Xing-Zao/Shenfenpai-Guangyingtanceyi/README.md

# 灵笼身份牌和光影探测仪软硬件开源资料




[灵笼身份牌](https://www.bilibili.com/video/BV1do4y1f7v5) 和 灵笼光[影探测仪](https://www.bilibili.com/video/BV1FK411F7UJ)的配套软硬件资料。

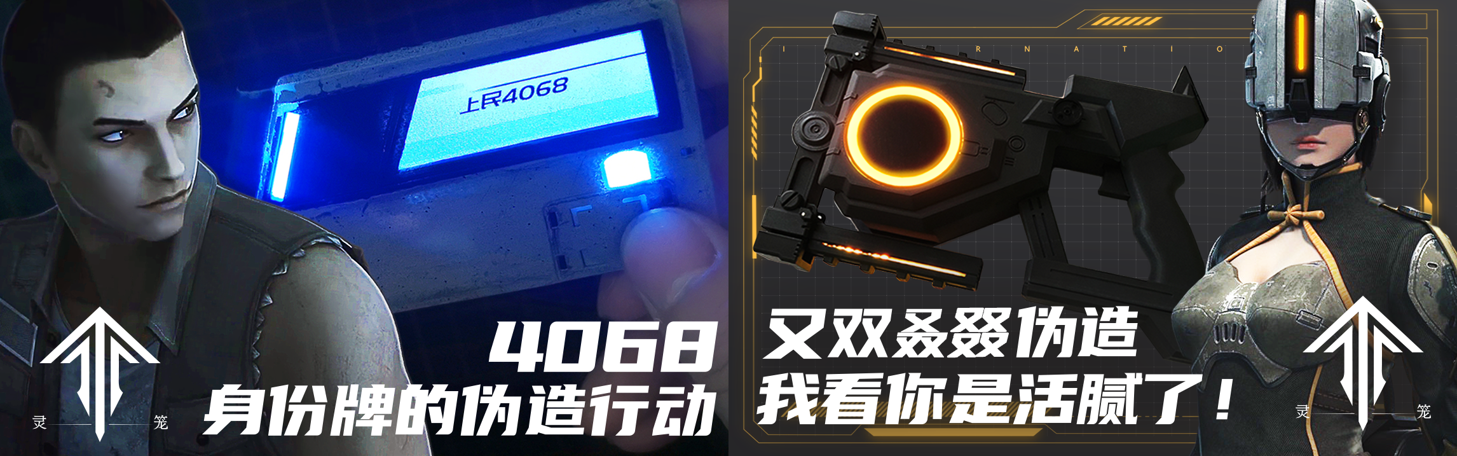
[picture p1: images/Posts/README/视频封面.png]
图 1
  

## 如何找到文件
- Light_detector 光影探测仪全部资料
- Badge 身份牌全部资料

每个文件夹下面都包含以下文件：
### 00_Priority README
该目录下存放了该控制板项目的全部**技术文档**，对该项目的程序源码、PCB设计都有详细说明，请首先阅读。
>文档目前尚未编写完成
>
### 01_Firmware
该目录下存放了 **软件/程序** 相关的全部源文件

### 02_Electronics
该目录下存放了 **电路/PCB** 相关的全部源文件

### 04_others
即不属于 软件/程序 也不属于 电路/PCB，但和本项目相关的其它文件

###  README.txt
每个文件夹下都有该文档，请**首先阅读**。这包含有其所处文件夹的阅读索引及一些重要说明。

## 支持

资料还在修改中，为了获得最佳的配置和故障排除帮助，请使用以下资源：
- 哔哩哔哩：[猩造](https://space.bilibili.com/16614468/)  
- 微信加群：
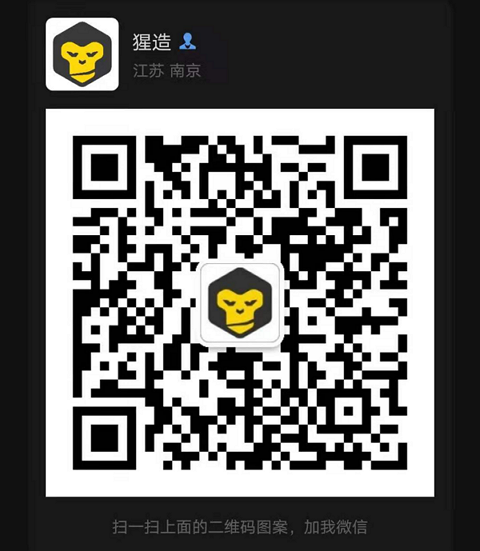
[picture p2: images/Posts/README/微信加群.png]
图 2
  

## 许可协议

FeixueMask 是遵循 [GPL license](/LICENSE) 协议发行的，因为我们相信开放式开发。 GPL附带了权利和义务。 无论您使用 FeixueMask 固件作为开源产品还是封闭源产品的驱动程序，都必须保持 FeixueMask 开放，并且必须根据要求向最终用户提供兼容的 FeixueMask 源代码。 遵守 FeixueMask 许可证的最直接方法是在 Github 上制作 FeixueMask 的分支，执行您的修改，并将用户引导到您修改后的分支。

虽然我们不能禁止在具有封闭源代码或有专利保护的产品中使用此代码，但我们还是希望您选择其他固件，或者最好自己制作。
