Xing-Zao/Shenfenpai-Guangyingtanceyi/Badge/Badge-A/02_Electronics/01_source/01_new_source/README.txt

A1.0  2020-08-18
  原理图错误：
    1. Q1 引脚1、2颠倒（main、LED）
    2. RX接MCU引脚错误，应接PA10（main）
    3. 电容C2~5 值错误，应为 0.1uF（main）

V1.0  2020-08-21
   版本更新：
     1. 修复上一版设计错误（main、LED）
     2. LED灯板重新设计，三色灯改为单色灯（LED）
  版本错误：
