Xing-Zao/Shenfenpai-Guangyingtanceyi/Badge/Badge-A/00_Priority README/技术文档源件.pdf

# 技术⽂档源件

# LonlyPan

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
灵笼-⾝份牌硬件开发技术⽂档

简介

功能

关键技术

难点

ToDo

约定

常⽤缩写及含义

+、-号

1、Alpha版

### 1.1 硬件设计

⽅案选择

充电

LCD显⽰屏

主控

flash

电路设计

### 1.2 软件设计

外设资源

初始化配置

主要流程

⽂件结构说明

API及函数说明

show_name()

change_to_up()

change_to_down()

remote_change_pic(u8 key)

LCD_Flash_Pic(u16 x,u16 y,u16 length,u16 width,const char* path)

Remote_Scan(void)

参考资料

# 灵笼-⾝份牌硬件开发技术⽂档

姓名 | LonlyPan
职位 | 嵌⼊式⼯程师
项⽬时间 | 2021/01/01 - 2021/05/10
2021/05/10 第⼀版
2020/xx/xx 第⼆版

灵笼-⾝份牌硬件开发技术⽂档

1/9

简介

该套设备是配套灵笼⾝份牌使⽤，模仿动漫中的功能，实现屏幕显⽰，红外接收信息。 相关视频：【灵笼】鸽了4个⽉，就做了这么个简单的胸牌？ (https://www.bilibili.com/video/BV1do4y1f7v5)
功能

通过屏幕显⽰两种⾝份状态，RGB灯跟随屏幕主⾊变化显⽰。 采⽤锂电池供电、可充电。
红外接收遥控信号，更改⾝份状态显⽰及其它⾃定义功能。 外置Flash存储，存放字库和显⽰图⽚，⽤于屏幕显⽰。
可通过usb_device 功能通过usb连接电脑⾃定义修改flash中的⽂本⽂件内容，通过红外遥控在屏幕中显 ⽰该⽂本内容。

## 关键技术

LCD 8位并口驱动显⽰
红外接收
RGB灯驱动
锂电池充放电
flash外置存储及模拟u盘
难点

TFT屏幕驱动
红外解码
Fatfs⽂件系统（访问Flash中⽂件）
USB_Device：连接PC修改Flash中⽂本⽂件内容 中⽂显⽰（含字库制作）
图⽚显⽰（从falsh读取显⽰）

## ToDo

NFC
续航增加
屏幕驱动修改为SPI，节省外设资源和布线

简介

2/9

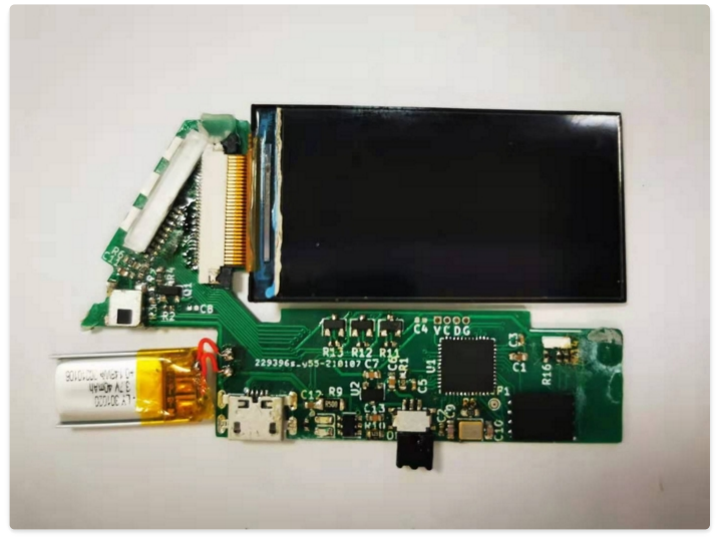
[picture p21: figure]

实物图

简介

3/9

约定

## 常⽤缩写及含义

+、-号

变量和函数前的

“+”号表⽰公有成员
“-”号表⽰私有成员

例如：
+boolenqueue(&item)：表⽰⽅法 enqueue(&item)为公有成员，对外公开 -enabled_globally：表⽰变量 enabled_globally为私有成员，只可在所在⽂件内访问
@file | ⽂件名
@author | 作者
@brief | 简要说明
@details | 实现细节
@param | ⽤于函数说明中，后⾯接参数名字，然后再接关于该参数的说明
@return | 返回值综述
@retval | 返回值列举并说明
@note | 注解信息
@attention | 注意信息
@warning | 警告信息
@see | 表⽰交叉参考
@ToDo | 计划实现的Marlin程序讲解1/34

约定

4/9

# 1、Alpha版

技术选型和验证阶段，⽅案未确⽴阶段

## 1.1 硬件设计

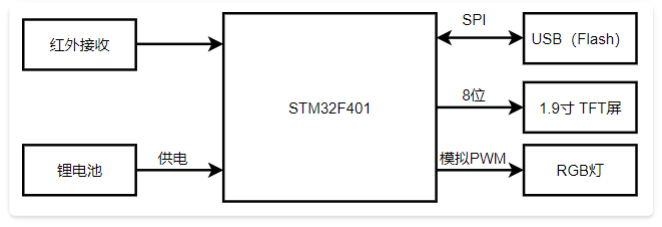
[picture p22: figure]

详细请阅读PCB设计⽂件。
BOM表中也列出了各元件的购买渠道。

## ⽅案选择

受限于外壳尺⼨，和内部电路板空间限制，屏幕、电池、USB接口、红外接收、RGB灯、flash的封装、外形均为限定， 故选择。

充电

充电芯⽚选择现有规格，另⼀⽅⾯也考虑了尺⼨因素。相同封装尺⼨下，也可选择其它充电芯⽚。⽆其它特殊技术 要求。

## LCD显⽰屏

LCD采⽤8位接口，考虑到显⽰速度因素。后期发现普通IO下⽆法使⽤DMA驱动，故速度⼀般。 下⼀版设计考虑 SPI+DMA 设计⽅案。

主控

采⽤常⽤、已有芯⽚。⽆其它特殊技术要求。

## flash

实际使⽤128M容量的，但64M即满⾜使⽤，两者仅驱动程序上需改。

系统框架

5/9

## 电路设计

电路设计部分均参考元件资料中的参考设计。

## 1.2 软件设计

## 外设资源

GPIO：屏幕8位并口驱动
TIM2：红外输⼊捕获
TIM10：RGB灯软件PWM驱动
SPI1：flash驱动
USB_FS、FATFS、USB_DEVICE：⽂件系统，USB通信

## 初始化配置

请参考程序源码。

## 主要流程

开机会显⽰4068上⺠（蓝⾊）图⽚、RGB灯光也显⽰为蓝⾊ 紧接会显⽰⾃定义内容（显⽰⾃定义内容（替换4068字符）或者显⽰⾃定义图⽚） 之后会移植扫描红外接收，科技通过遥控切换不同显⽰界⾯，或者显⽰4068上⺠和尘⺠切换动画。

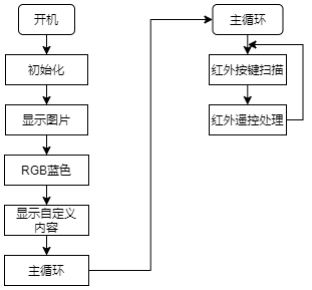
[picture p23: figure]

## ⽂件结构说明

Badge.c/h 主程序
cc.h ⾃定义⼀些数据类型供其它库⽂件使⽤

外设资源屏幕

6/9 common.h 最基础的公共头⽂件包含，基本每个源⽂件都要包含该头⽂件 lcd_font.h 常⽤ ASCII 字符表，⽤于LCD显⽰
lcd.c/h lcd底层驱动（初始话、发送命令等）,lcd⼀些简单画图功能函数 led.c/h RGB灯驱动
macros.h 公共声明定义
remoter.c/h 红外接收驱动
text.c/h 汉字显⽰
timer.c/h 定时器外设驱动
w25qxx.c/h W25QXX驱动代码

## API及函数说明

## show_name()

@brief: 显⽰⽤⼾⾃定义名称或三连图⽚
@note: 名称或图⽚只能同时显⽰⼀个。⾃定义名称来⾃⽂件 name.txt，需要⽤⼾⾃⼰修改，为空则不显⽰

## change_to_up()

@brief: 转为上⺠
@note: 根据动漫内容，展⽰从尘⺠变为上⺠的胸牌显⽰变化

## change_to_down()

@brief: 转为尘⺠
@note: 根据动漫内容，展⽰从上⺠变为尘⺠的胸牌显⽰变化

## remote_change_pic(u8 key)

@brief: 红外遥控处理
@note: 可使⽤遥控更改胸牌界⾯显⽰内容，不同遥控对应的键值可能会不同，需⾃⾏适配 @param {u8} key 红外遥控键值

## LCD_Flash_Pic(u16 x,u16 y,u16 length,u16 width,const char* path)

@brief 显⽰flash中的图⽚
@param: x,y起点坐标
@param: length 图⽚⻓度
@param: width 图⽚宽度
@param: *path 图⽚地址

## Remote_Scan(void)

7/9

@brief 处理红外键盘
@retval: 0,没有任何按键按下 其他,按下的按键键值.

## 参考资料

TFT屏幕驱动

STM32萌新学习笔记-LCD实验 (https://www.bilibili.com/read/cv6991648/)
⼀个简单的stm32vet6驱动2.4⼨240X320的8位并口tft屏DEMO (https://www.cnblogs.com/zjutlitao/p/4999363.html) 关于8位并口lcd写数据 (https://bbs.csdn.net/topics/390306089)
STM32 16位IO口操作的⼀些教训 (http://news.eeworld.com.cn/mcu/article_2017092634758.html)
请问STM32怎么才能并⾏操作低⼋位的IO口或⾼⼋位的IO口？ (https://zhidao.baidu.com/question/524842165.html) 基于 HAL 库⽣成的代码添加 GPIO 字节（组）操作功能 驱动1602 (https://www.jianshu.com/p/f579830bd6d0) ILI9341驱动的LCD屏刷屏很慢要什么解决？ (https://bbs.elecfans.com/jishu_1521747_1_1.html)
OLED显⽰屏驱动：8080并口，IIC，SPI三种驱动⽅式 (https://www.geek-share.com/detail/2791508605.html)
ili9341 8bit模式驱动说明 (https://www.pianshen.com/article/96241503123/)
ILI9341液晶显⽰ (https://www.shuzhiduo.com/A/A2dm6jn4ze/)
分享我的STM32刷图测试代码：STM32F103+SDIO+ILI9325 播放60fps视频 (https://www.amobbs.com/forum.php?mod=viewthread&tid=5597206&highlight=%25E8%25A7%2586%25E9%25A2%2591%252Bsdio) 怎么对⾼⼋位或低⼋位写值而不影响其它位，还有怎样单独读取⾼⼋位或低⼋位的值 (https://blog.csdn.net/TXF1984/article/details/46563521)

红外解码

主要参考正点原⼦红外解码例程。

红外遥控器-VS1838B/HS0038红外接收⽅案（包含原理图+PCB+BOM表+程序） (https://www.cnblogs.com/chengo/p/12759808.html) [每⽇电路图] 2、红外遥控电路原理设计与解析【转+解读】 (https://www.cnblogs.com/zjutlitao/p/5122983.html)

Fatfs⽂件系统、字库

STM32CubeMX系列教程18:⽂件系统FATFS (https://wiki.diustou.com/STM32CubeMX%25E7%25B3%25BB%25E5%2588%2597%25E6%2595%2599%25E7%25A8%258B18:%25E6%2596%2587%25E4%25BB%25B6%25E7%25B3%25BB%25E7%25BB%259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)
FSMC-TFT LCD调试记录 (https://stm32f407-tech-doc.readthedocs.io/en/latest/base/13FSMC/FSMC-TFT%20LCD%25E8%25B0%2583%25E8%25AF%2595%25E8%25AE%25B0%25E5%25BD%2595.html)
HAL库教程【HAL库每天⼀例】第054例：LCD-显⽰图⽚(图⽚在SD卡) (http://www.ing10bbs.com/forum.php?mod=viewthread&tid=312) 基于stm32f103zet6的FAT16⽂件系统学习4（管理SD卡，读取图⽚，字库） (http://www.javamy.com/it/x1843717577511633000/stm32) Tutorial: An SD card over SPI using STM32CubeIDE and FatFS (https://01001000.xyz/2020-08-09-Tutorial-STM32CubeIDE-SD-card/) stm32--FatFs调试过程（SPIFlash） (http://itren.xiaolee.net/p/2148706.html)
stm32--FatFs移植（SPIFlash） (https://www.cnblogs.com/cage666/p/9178326.html)
STM32Cube-20（补充）| 在SD卡上移植FATFS⽂件系统 (https://cloud.tencent.com/developer/article/1662818)

字体显⽰

【教程】中英⽂显⽰取模设置 (http://www.lcdwiki.com/zh/%25E3%2580%2590%25E6%2595%2599%25E7%25A8%258B%25E3%2580%2591%25E4%25B8%25AD%25E8%258B%25B1%25E6%2596%2587%25E6%2598%25BE%25E7%25A4%2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)

开发板通⽤（\ 128*128\）⼤字体常⽤ASCII显⽰ (http://www.openedv.com/forum.php?mod=viewthread&tid=289623) 8/9 miniF103 MINIV3 32号字体显⽰测试程序（从SPI FLASH读取汉字字库） (http://www.openedv.com/forum.php?mod=viewthread&tid=279050&highlight=32%25BA%25C5%25D7%25D6%25CC%25E5)

显⽰24*24字体 (http://www.openedv.com/thread-4920-1-1.html)

STM32汉字字库显⽰（从SD卡读取数据） (http://bbs.eeworld.com.cn/thread-493755-1-1.html)

基于STM32的简单电⼦书的实现 (https://zhuanlan.zhihu.com/p/79174160)

原创 littlevgl(LVGL v7.0) 外部SD卡存放中⽂字库并显⽰ (https://www.stmcu.org.cn/module/forum/thread-625813-1-1.html)

汉字点阵字库模块 (https://stm32f407-tech-doc.readthedocs.io/en/latest/base/26%25E6%25B1%2589%25E5%25AD%2597%25E5%25AD%2597%25E5%25BA%2593/%25E6%25B1%2589%25E5%25AD%2597%25E7%25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)

USB_Device

STM32HAL----USB串⾏FLASH模拟U盘 (https://blog.csdn.net/a3748622/article/details/80347730) 基于STM32F103C8的 USB 外部flash虚拟U盘 (https://blog.csdn.net/qq997758497/article/details/102763470) STM32f103+W25Q64实现虚拟U盘和FATFS⽂件系统 (https://blog.csdn.net/Jun626/article/details/80426643) STM32的USB-Device不能识别问题的解决 (https://blog.csdn.net/qq_16597387/article/details/93094052)
How to use Flash Drive with STM32 || USB HOST MSC || CubeIDE (https://www.youtube.com/watch?v=_bfROydrssA) STM32 USB Mass Storage 例程调试笔记【转载】 (http://blog.sina.com.cn/s/blog_7880d3350101n2ja.html) STM32+FLASH实现u盘(2) (http://www.ec66.com/article/list.asp?indexid=4656)
⽤STM32CubeMX快速⽣成⼀个U盘模拟程序 (https://wenku.baidu.com/view/6883eccf9fc3d5bbfd0a79563c1ec5da50e2d6c1.html?re=view)
stm32模拟U盘，cubemx⽣成的代码，可以看到盘⽆法格式化 (http://47.111.11.73/thread-304933-1-1.html) 已解决 STM32F103VE SPI1驱动SD卡模拟U盘，⽆法格式化 (https://www.stmcu.org.cn/module/forum/thread-597120-1-1.html) STM32F446移植USB驱动，实现外部FLASH模拟U盘 (https://blog.csdn.net/asher__zhou/article/details/105916971) 使⽤STM32CUBEMX 新HAL库TF卡模拟U盘不能格式化问题 (https://blog.csdn.net/ffmydream/article/details/89926213) STM32 USB-Host-Device_Lib_V2.1.0 SPIflash ⽆法格式化问题 (https://www.cnblogs.com/alinweb/p/3520660.html) stm32USB之模拟U盘 (https://blog.csdn.net/qq_38420206/article/details/110572003)
STM32CbueMX之USB挂载内存虚拟U盘 (https://blog.csdn.net/sudaroot/article/details/94602949)

9/9
