Xing-Zao/Shenfenpai-Guangyingtanceyi/Badge/Badge-A/README.txt

00_Priority README ------------- 技术文档，首先阅读
01_Firmware --------------------- 软件相关文件夹
02_Electronics -------------------- 电路相关文件夹
03_Machines --------------------- 机械相关文件夹
04_others ------------------------ 其他文件

README,txt --------------------- 每个分类文件夹都有，含有所处文件夹的阅读索引及必要说明，请最先阅读
