Xing-Zao/Shenfenpai-Guangyingtanceyi/Badge/Badge-A/00_Priority README/README.txt

01-source ---- 存放技术文档源文档

xxx.pdf为技术文档(上述源文档的导出版)
