Xing-Zao/Shenfenpai-Guangyingtanceyi/Badge/Badge-A/02_Electronics/01_source/README.txt

01_new_source -------------------------------- 存放最新源码（该目录仅存放一个最新版本）
    |________ Vx.x.x  --------------------  最新版本号
	     |________ 源码名1
	     |________ 源码名2  --------------------  有的工程可能会有同时多个源码

02_old_source --------------------------------- 存放已迭代源码
    |________ Vx.x.x  --------------------  旧版本号
	     |________ 源码名1
	     |________ 源码名2
    |________ Vx.x.x  --------------------  旧版本号
	 ......

有的编程软件可能不支持中文路径，需单独保存到全英文路径在运行
