Xing-Zao/Shenfenpai-Guangyingtanceyi/Badge/Badge-A/00_Priority README/01_source/README.txt

该文件夹下存放技术文档的源文档

如果想要阅读该目录下的文件，请转至该文件夹的上级文件夹，阅读其内与该文件夹同名的 .pdf 文件（.pdf为该目录下 .md文档 的导出文件）。

请使用 Visual Studio Code 打开该文件的所属文件夹（01_source），打开.md文档编辑修改。
vs code插件推荐：
    Markdown Image
    Markdown Preview Enhanced
