Xing-Zao/Shenfenpai-Guangyingtanceyi/Light_detector/04_others/红外解码模块+编码模块+红外无线通信+接收发射串口通信模块/YS-NEC编解码模块 原理图.pdf

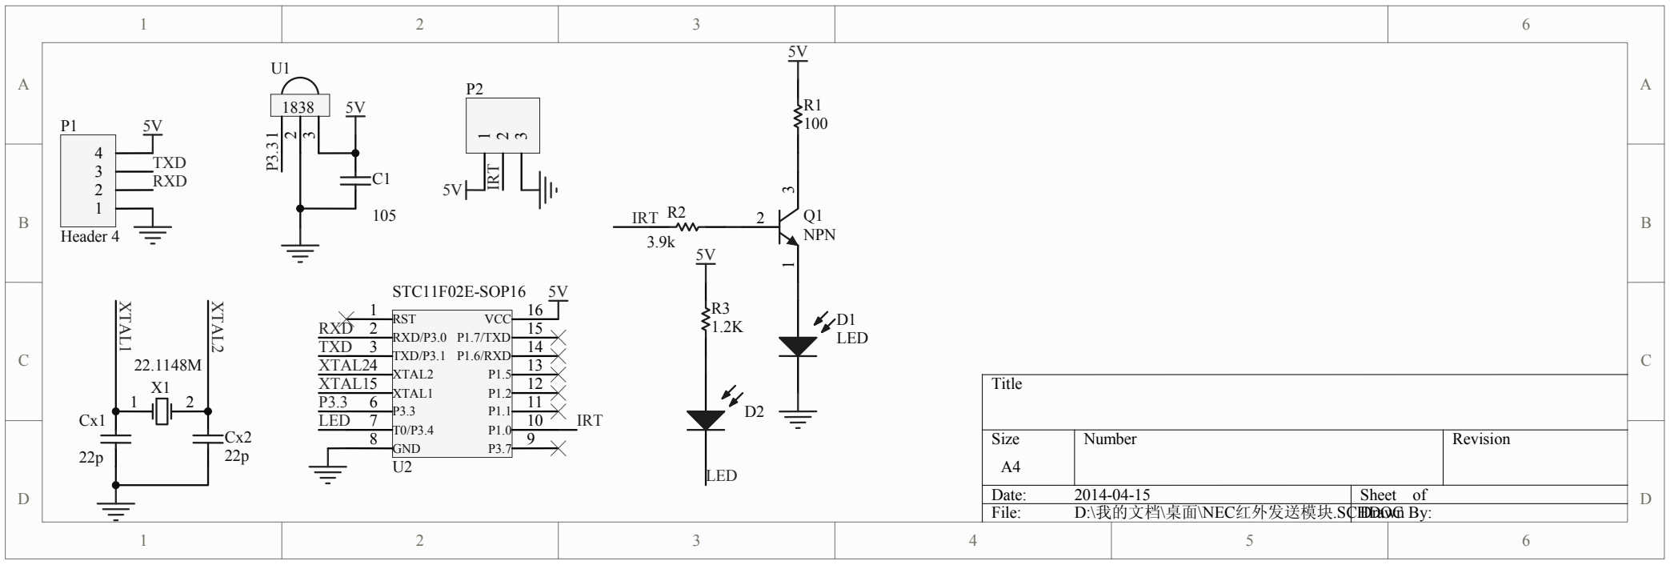
[picture p27: figure]
umb; HDDraOwCn; XTAL2; XTAL1; IRT
