Xing-Zao/Shenfenpai-Guangyingtanceyi/images/Posts/README/个人二维码.jpg

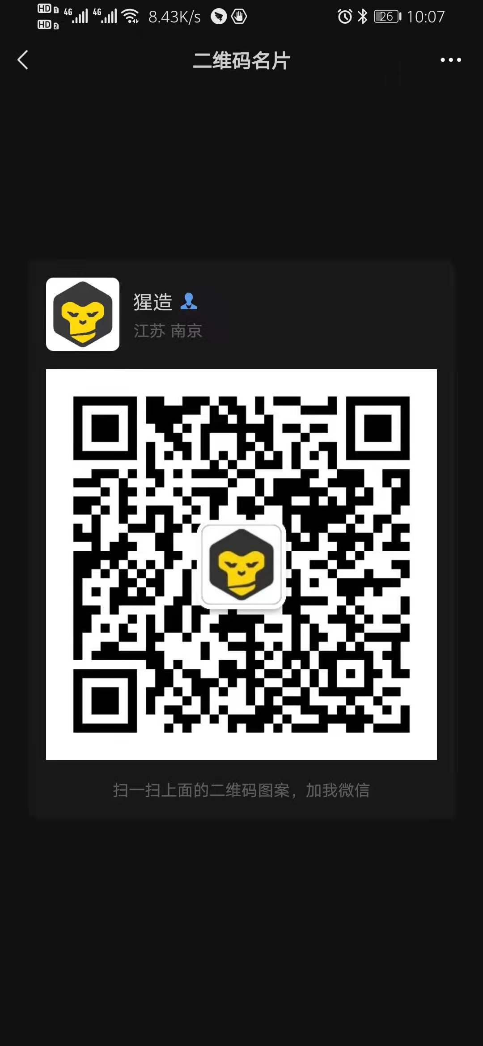
images/Posts/README/个人二维码.jpg
