Xing-Zao/Shenfenpai-Guangyingtanceyi/Light_detector/04_others/04-LCD取模教程/page1.jpg

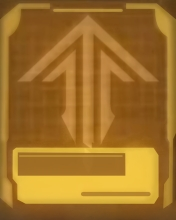
Light_detector/04_others/04-LCD取模教程/page1.jpg
