Xing-Zao/Shenfenpai-Guangyingtanceyi/Light_detector/04_others/04-LCD取模教程/已完成.jpg

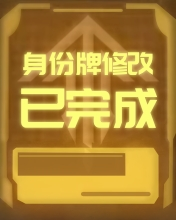
Light_detector/04_others/04-LCD取模教程/已完成.jpg
