Xing-Zao/Shenfenpai-Guangyingtanceyi/Light_detector/04_others/04-LCD取模教程/读取中.jpg

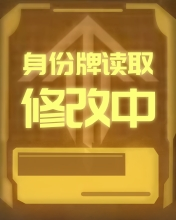
Light_detector/04_others/04-LCD取模教程/读取中.jpg
