Xing-Zao/Shenfenpai-Guangyingtanceyi/Light_detector/02_Electronics/01_source/01_new_source/main_V1.1/BOM/BOM.xlsx

Reference | Quantity | Value | Footprint | Datasheet | Description | 采购建议
BT1 | 1 | Battery | JWT_A3963_1x02_P3.96mm_Vertical |  | 电源接头，人工焊接 | 无需购买
C1 C7 C11 C10 C13 | 5 | 22uF | C_1206_3216Metric | ~ |  | 非指定厂家，符合：Value、Footprint 即可
C12 | 1 | 330nF | C_0402_1005Metric | ~ |  | 非指定厂家，符合：Value、Footprint 即可
C14 C23 | 2 | 2.2uF | C_0603_1608Metric | ~ |  | 非指定厂家，符合：Value、Footprint 即可
C15 C18 | 2 | 1uF | C_0603_1608Metric | ~ |  | 非指定厂家，符合：Value、Footprint 即可
C17 C16 | 2 | 22pF | C_0402_1005Metric | ~ |  | 非指定厂家，符合：Value、Footprint 即可
C19 C20 C21 C22 | 4 | 0.1uF | C_0402_1005Metric | ~ |  | 非指定厂家，符合：Value、Footprint 即可
C2 | 1 | 10nF | C_0402_1005Metric | ~ |  | 非指定厂家，符合：Value、Footprint 即可
C6 C5 C3 C4 | 4 | 100nF | C_0402_1005Metric | ~ |  | 非指定厂家，符合：Value、Footprint 即可
C8 | 1 | 82pF | C_0402_1005Metric | ~ |  | 非指定厂家，符合：Value、Footprint 即可
C9 C24 | 2 | 4.7uF | C_1206_3216Metric | ~ |  | 非指定厂家，符合：Value、Footprint 即可
D1 | 1 | SS34 | D_SMA | 见数据表：01-SS34_2019-07-29.PDF |  | 指定厂家
D2 | 1 | G | LED_0603_1608Metric | ~ | 绿色 | 非指定厂家，符合：Value、Footprint 即可
D3 | 1 | R | LED_0603_1608Metric | ~ | 红色 | 非指定厂家，符合：Value、Footprint 即可
D4 | 1 | remote | Con-2.5mm_0.9x1.7 | ~ | 红外发射LED接口，人工焊接 | 无需购买
D5 | 1 | B550C | D_SMC | ~ | 肖特基二极管 | 非指定厂家，符合：Value、Footprint 即可
IC1 IC2 | 2 | HY2213-BB3A | SOT95P280X140-6N | 见数据表：02-DS-HY2213_单节电池_充电平衡.pdf |  | 指定厂家
IC3 | 1 | RT8279GSP | Diodes_SO-8EP | 见数据表：03-RT8279GSP-5V_DC-DC_5A-降压_2017-07-12.PDF |  | 指定厂家
J1 | 1 | USB_B_Micro | USB_Micro-B_Molex-105017-0001 | 见数据表：04-MICROUSB母座小牛角有柱卷边编带_2019-07-22.PDF |  | 指定厂家
J6 | 1 | SERVOA | Connector_PinHeader_2.54mm:PinHeader_1x03_P2.54mm_Horizontal | ~ | 舵机接口，2.54弯排针 | 非指定厂家，符合：Value、Footprint 即可
J10 | 1 | SERVOB | PinHeader_1x03_P2.54mm_Horizontal | ~
J2 | 1 | BAT | JST_XH_S3B-XH-A-1_1x03_P2.50mm_Horizontal | ~ | 电池充电接口，，XH 3A 母座 | 非指定厂家，符合：Value、Footprint 即可
J4 | 1 | SWD | Connector_PinHeader_1.27mm:PinHeader_1x04_P1.27mm_Vertical | ~ | 下载调试接口，不焊接 | 无需购买
J5 | 1 | Conn_01x16 | Connector_FFC-FPC:TE_1-1734839-6_1x16-1MP_P0.5mm_Horizontal | ~ | FPC连接器 0.5MM 翻盖下接 16P | 非指定厂家，符合：Value、Footprint 即可
J7 | 1 | LEDA | JST_XH_S3B-XH-A-1_1x03_P2.50mm_Horizontal | ~ | WS2812 灯带接口，XH 3A 母座 | 非指定厂家，符合：Value、Footprint 即可
J11 | 1 | LEDB | JST_XH_S3B-XH-A-1_1x03_P2.50mm_Horizontal | ~
J8 | 1 | LEDC | JST_XH_S3B-XH-A-1_1x03_P2.50mm_Horizontal | ~
J9 | 1 | LEDD | JST_XH_S3B-XH-A-1_1x03_P2.50mm_Horizontal | ~
L1 | 1 | 3.3uH | L_Sumida_CDMC6D28_7.25x6.5mm | 见数据表：05-3.3UH±20%6A_2019-05-30.PDF | MCS0630-3R3MN2 | 指定厂家，厂家编号：MCS0630-3R3MN2
L2 | 1 | 10uH | L_Neosid_SM-PIC1004H | 见数据表：06-10UH±20%6A_2020-07-20.PDF |  | 指定厂家，厂家编号：PSPMAA1040H-100M-ANP
Q1 Q2 | 2 | SI2300 | SOT-23 | 见数据表：07-SI2300-N_MOSFET_2020-04-16.PDF |  | 指定厂家
Q5 Q4 | 2 | SS8050 | SOT-23 | 见数据表：08-SS8050Y1200-350.PDF |  | 指定厂家
R11 | 1 | 31.6k | R_0402_1005Metric | ~ |  | 非指定厂家，符合：Value、Footprint 即可
R14 | 1 | 5.1K | R_0402_1005Metric | ~
R15 R4 R10 | 3 | 100K | R_0402_1005Metric | ~
R16 | 1 | 10M | R_0402_1005Metric | ~
R17 R21 | 2 | 100R | R_0603_1608Metric | ~
R18 R12 R13 R19 | 4 | 1K | R_0402_1005Metric | ~
R23 | 1 | 10R | R_0603_1608Metric | ~
R5 R20 R22 R3 R6 | 5 | 10K | R_0402_1005Metric | ~
R7 R1 R2 | 3 | 100R | R_0402_1005Metric | ~
R8 R9 | 2 | 20R | R_2512_6332Metric | ~
SW1 | 1 | Power_BT | JST_XH_S2B-XH-A-1_1x02_P2.50mm_Horizontal | ~ | 电源开关接口，XH2A，实际短接 | 无需购买
U1 | 1 | SLM4800 | QFN-16-1EP_4x4mm_P0.65mm_EP2.1x2.1mm_ThermalVias | 见数据表：09-SLM6800-两节锂电池升压充电IC_2019-04-19.PDF |  | 指定厂家
U2 | 1 | XC6206 | SOT-23 | 见数据表：10-XC6206P302MR.PDF |  | 指定厂家
U3 | 1 | STM32F401CCUx | QFN-48-1EP_7x7mm_P0.5mm_EP5.6x5.6mm | 见数据表：11-STM32F401CCU6_2016-08-16.PDF |  | 指定厂家
U4 | 1 | TSMP58138 | Vishay_MINICAST-3Pin |  | 红外接收芯片，实际未用到、保留设计 | 无需购买
U5 | 1 | W25Q128JVS | SON127P800X600X80-9N-D | 见数据表：12-W25Q64JVZEIQ_2020-06-23.PDF |  | 指定厂家
U8 U6 U7 | 3 | SN74LVC2T45DCUR | VSSOP-8_2.4x2.1mm_P0.5mm | 见数据表：13-SN74LVC2T45DCUR-电平转换_2014-07-11.PDF |  | 指定厂家
U9 | 1 | AO4459 | SOP-8_3.9x4.9mm_P1.27mm | 见数据表：14-AO4459-30V_6.5A-P_MOS-2015-06-01.PDF |  | 指定厂家
Y1 | 1 | 25MHz/20pF/10ppm | Crystal_SMD_2520-4Pin_2.5x2.0mm | 见数据表：15-25M20PPM20PF-30+85℃_2018-07-26.PDF |  | 指定厂家
其它原件
 | 1 | 锂电池 | 2S 5C 7.4V 圆柱锂电池 SM公头 |  |  | 推荐厂家：淘宝：汇成玩具电池 型号：7.4V 18650 圆柱锂电池
 | 1 | 2.2寸显示屏 | 2.2寸TFT液晶屏 插接式 MCU 8位 | 见数据表：16-CL22BK122-16A.pdf |  | 指定厂家，淘宝：永达创力 型号：2.2寸TFT液晶屏 显示屏 彩屏 插接式 插拔式屏 LCD液晶屏MCU 8位
 |  | FPC排线 | 16P 间距0.5mm 长度25cm 同向 | ~ | 屏幕接线延长线 | 非指定厂家，符合：Value、Footprint 即可
 |  | FPC延长板 | 0.5mm间距 16P FPC/FFC软排线扁平线延长板 |  | 延长转接板 | 非指定厂家，符合：Value、Footprint 即可
 |  | 红外发射头 | 3MM发射管 940nm红外发射管 |  | 插件 | 非指定厂家，符合：Value、Footprint 即可
