Xing-Zao/Shenfenpai-Guangyingtanceyi/Badge/Badge-A/02_Electronics/01_source/01_new_source/main_V1.0/BOM/BOM.xlsx

Reference | Quantity | Value | Footprint | Datasheet | Description | 采购建议
BT1 | 1 | Li-on | Pad-2.2mm_1.5x1.5 | ~ | 电池接口焊点，人工焊接 | 无需购买
C1 C11 | 2 | 2.2uF ±10% 6.3V/10V/16V | C_0603_1608Metric | ~ |  | 非指定厂家，符合：Value、Footprint 即可
C10 C9 | 2 | 22pF ±10% 6.3V/10V/16V | C_0603_1608Metric | ~ |  | 非指定厂家，符合：Value、Footprint 即可
C2 C3 C4 C5 C8 | 5 | 0.1uF ±10% 6.3V/10V/16V | C_0402_1005Metric | ~ |  | 非指定厂家，符合：Value、Footprint 即可
C6 C7 C12 C13 | 4 | 1uF ±10% 6.3V/10V/16V | C_0603_1608Metric | ~ |  | 非指定厂家，符合：Value、Footprint 即可
D2 | 1 | G_LED IF<25mA | LED_0603_1608Metric | ~ |  | 非指定厂家，符合：Value、Footprint 即可
D3 | 1 | R_LED IF<25mA | LED_0603_1608Metric | ~ |  | 非指定厂家，符合：Value、Footprint 即可
IC1 | 1 | TP4057 | SOT-23-6 | 见数据表：02-TP4057_2020-08-19.pdf | 锂电池充电芯片 | 指定厂家
J1 | 1 | Conn_01x30 | FFC-1x30-1MP_P0.5mm_Horizontal | 见数据表：03_FFCFPC连接器0.5MM间距30P卧贴抽拉式上接H1.2MM_2020-10-20.pdf | FFC 连接器 0.5mm间距 30P 卧贴抽拉式上接 H1.2mm | 指定厂家
J2 | 1 | USB_B_Micro | USB_Micro-B_Molex_Sink | 见数据表：04-MICRO_5SB型沉板式0.8四脚全插无导位有孔三边双卡端_2021-03-08.pdf | MICRO/5S B型沉板式0.8四脚全插无导位有孔三边双卡端 | 指定厂家
J3 | 1 | SWD | Con-1x4-P1.25mm | ~ | 下载调试接口，不焊接 | 无需购买
Q1 Q2 Q4 Q3 | 4 | SS8050 | SOT-23 | 见数据表：05-SS8050Y1200-350.pdf |  | 指定厂家
R1 | 1 | 100K ±5% 0.1W_1/16W | R_0603_1608Metric | ~ |  | 非指定厂家，符合：Value、Footprint 即可
R10 | 1 | 3K ±5% 0.1W_1/16W | R_0603_1608Metric | ~ |  | 非指定厂家，符合：Value、Footprint 即可
R14 R15 R16 R17 R18 R19 R20 R21 R22 R23 R24 R25 | 12 | 470R ±5% 0.1W_1/16W | R_0402_1005Metric | ~ |  | 非指定厂家，符合：Value、Footprint 即可
R2 R8 R11 R13 R12 | 5 | 1K ±5% 0.1W_1/16W | R_0402_1005Metric | ~ |  | 非指定厂家，符合：Value、Footprint 即可
R3 R7 | 2 | 10K ±5% 0.1W_1/16W | R_0603_1608Metric | ~ |  | 非指定厂家，符合：Value、Footprint 即可
R4 | 1 | 10R ±5% 0.1W_1/16W | R_0603_1608Metric | ~ |  | 非指定厂家，符合：Value、Footprint 即可
R5 | 1 | 10M ±5% 0.1W_1/16W | R_0603_1608Metric | ~ |  | 非指定厂家，符合：Value、Footprint 即可
R6 | 1 | 100R ±5% 0.1W_1/16W | R_0603_1608Metric | ~ |  | 非指定厂家，符合：Value、Footprint 即可
R9 | 1 | 0.5R ±5% 0.1W_1/16W | R_0805_2012Metric | ~ |  | 非指定厂家，符合：Value、Footprint 即可
SW1 | 1 | SW_SPDT | MSKT-12C00-switch-smd | 见数据表：10-开关规格.png | 侧贴拨动开关 | 指定厂家，淘宝：温州一键电子科技，型号MSKT-12C00 黑色
TP1 | 1 | NRST | TestPoint_Pad_D1.0mm | ~ | 测试焊点，不焊接 | 无需购买
U1 | 1 | STM32F401CCUx | QFN-48-1EP_7x7mm_P0.5mm_EP5.6x5.6mm | 见数据表：06-STM32F401CCU6_2016-08-16.pdf | 主控芯片，型号 STM32F401CCU6 | 指定厂家
U2 | 1 | XC6206 | SOT-23 | 见数据表：07-XC6206P302MR.pdf | 稳压降压芯片 | 指定厂家
U3 | 1 | IRM-H2XXT_TR2 | IRM-H2XXT_TR2 | 见数据表：08-红外线接收头38KHZ贴片_2017-09-18.PDF | 红外接收头 | 指定厂家
U4 | 1 | W25Q128JVS | SON127P800X600X80-9N-D | 见数据表：09-W25Q64JVZEIQ_2020-06-23.PDF | flash芯片，型号W25Q64JVIQ，封装WSON 8x6mm | 指定厂家
U5 U7 U8 U6 | 4 | LEB_BGAR | RGB-3510-Side-Common_anode | 见数据表：11-3510侧发RGB全彩_2020-09-04.PDF | 侧贴RGB全彩 | 指定厂家
Y1 | 1 | 25MHz/20pF/10ppm | Crystal_SMD_2520-4Pin_2.5x2.0mm | 见数据表：12-25M20PPM20PF-30+85℃_2018-07-26.PDF |  | 指定厂家
其它原件
 | 1 | 锂电池 | 尺寸：20x10x3mm 容量40mAh，带保护板 |  |  | 指定厂家，淘宝：裕辉达玩具数码电池户，型号301020 50mAh，带保护板
 | 1 | 1.9寸显示屏 | 1.9寸长条形IPS全视角170*320分辨率MCU接口 | 见数据表：13-TL019FQV01-B1263A_specification.pdf |  | 指定厂家，淘宝：深圳市显创液晶显示有限公司 型号：1.9寸长条形显示屏IPS全视角170*320分辨率
 | 1 | 背光板 | 18*8*1.3 |  | RGB侧面显示匀光板，需手工裁切 | 指定厂家，淘宝：深圳市宝晖光电 型号：18*8*1.3 白色背光板
