Xing-Zao/Shenfenpai-Guangyingtanceyi/Light_detector/04_others/2.2寸-176x220-9225G-8位-插接/CL22BK122-16A接线图.pdf

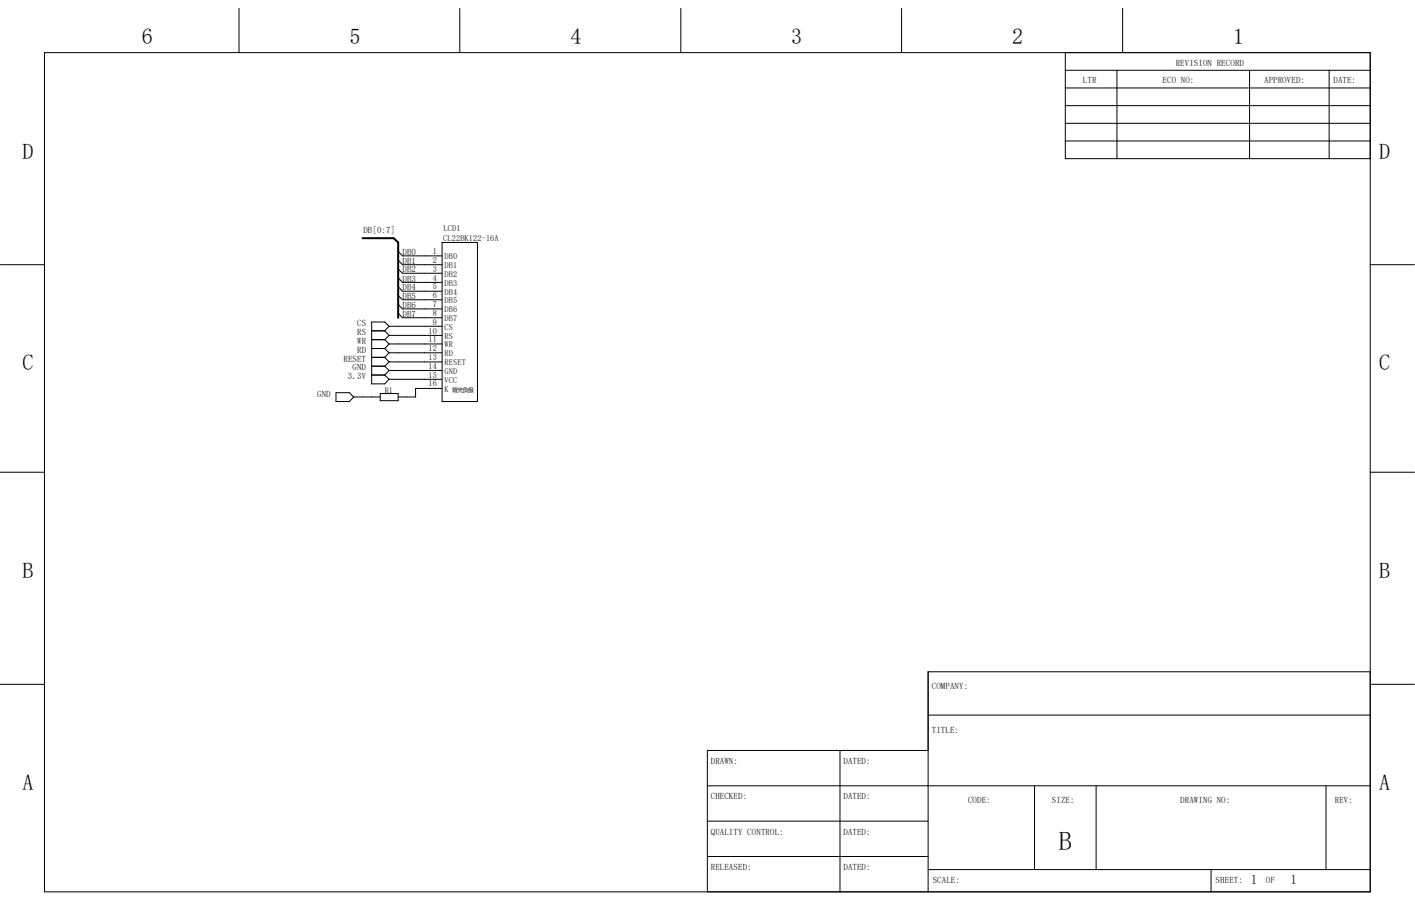
[picture p35: page 1]
COMPANY:; TITLE:; 背光负极; RESET 14; GND 15; VCC 16; CS RS WR RD RESET GND 3.3V; GND

LCD1 CL22BK122-16A | REVISION RECORD

LTR | ECO NO: | APPROVED: | DATE:

DRAWN: | DATED:
CHECKED: | DATED: | CODE: | SIZE: B | DRAWING NO: | REV:

QUALITY CONTROL: | DATED:

RELEASED: | DATED:

SCALE: | SHEET: 1 1 OF
