Xing-Zao/Shenfenpai-Guangyingtanceyi/Light_detector/02_Electronics/01_source/01_new_source/main_V1.1/Light_detector_V1.0.pdf

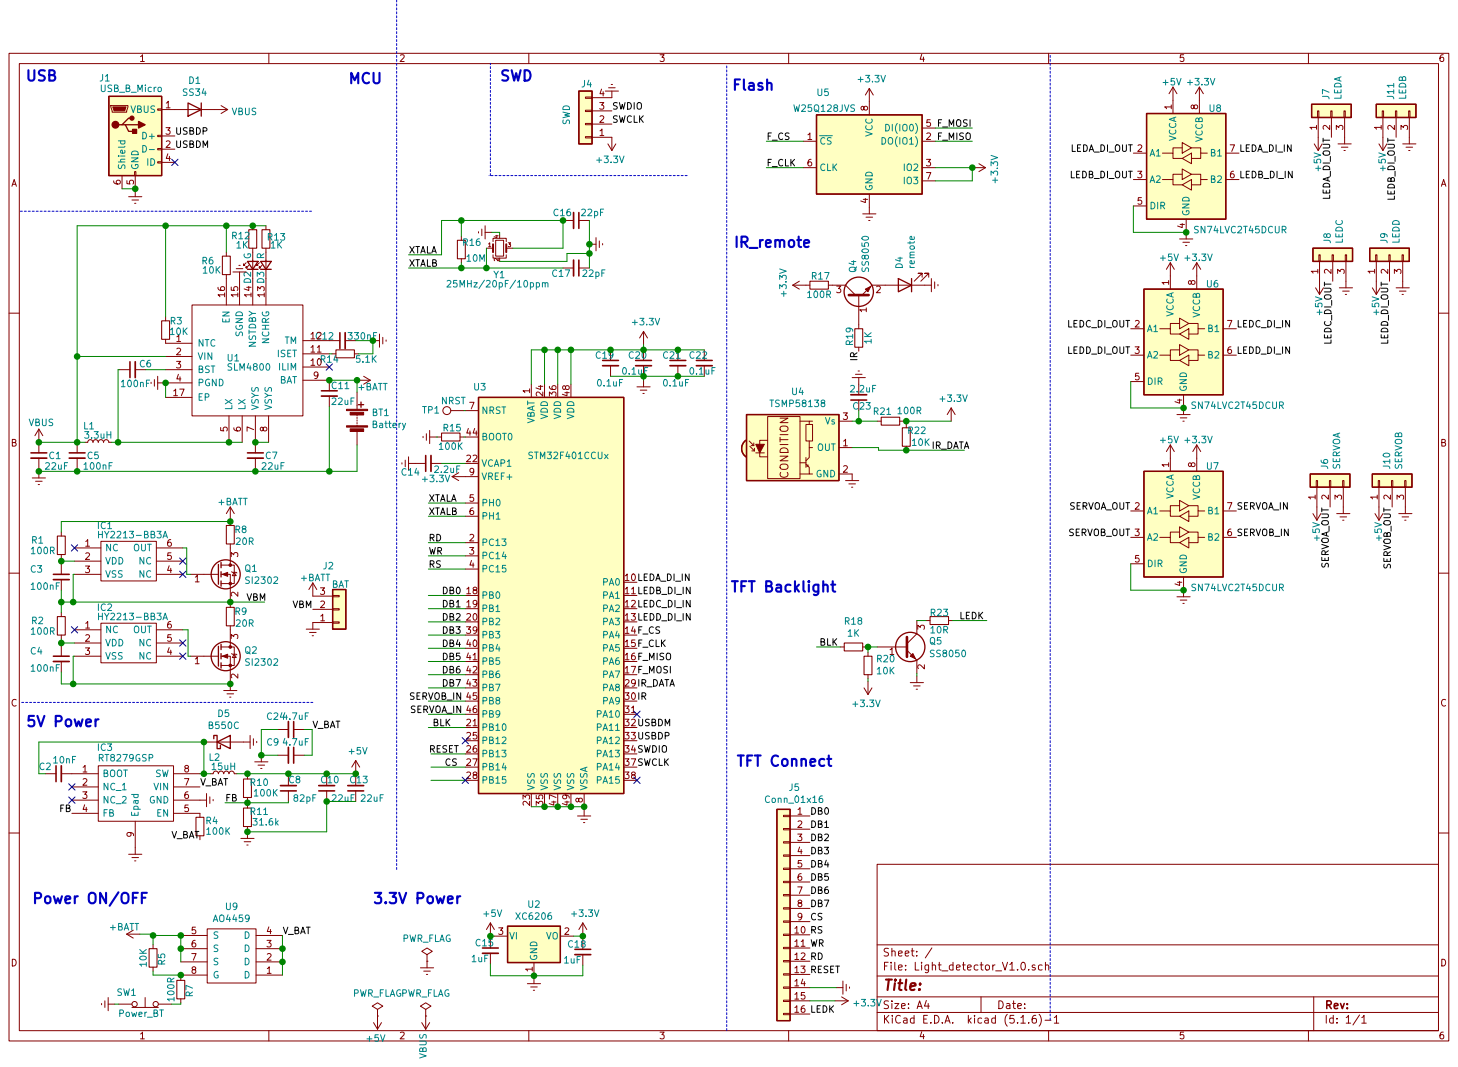
[picture p36: page 1]

1 VCAP1 22 VDD 24 VDD 36 VDD 48 VREF+ 9 VSS 23 VSS 35 VSS 47 VSS 49 VSSA
