Xing-Zao/Shenfenpai-Guangyingtanceyi/Badge/Badge-A/02_Electronics/01_source/01_new_source/main_V1.0/BOM/03_FFCFPC连接器0.5MM间距30P卧贴抽拉式上接H1.2MM_2020-10-20.PDF

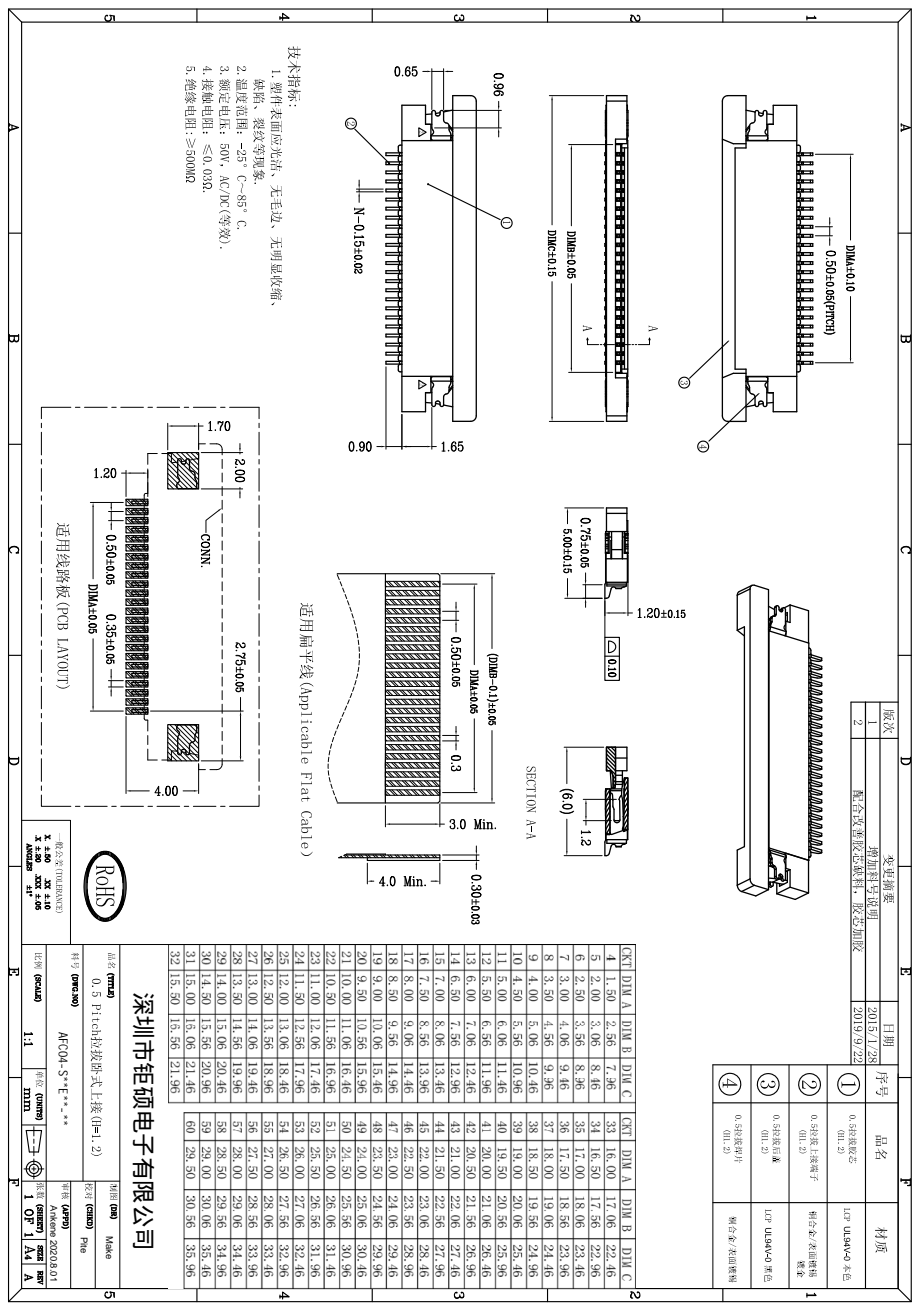
[picture p37: page 1]
深圳市钜硕电子有限公司; AFC04-S**E**-**; Ankene 2020.8.01; Pite; Make
