Xing-Zao/Shenfenpai-Guangyingtanceyi/Badge/Badge-A/02_Electronics/01_source/01_new_source/main_V1.0/BOM/04-MICRO_5SB型沉板式0.8四脚全插无导位有孔三边双卡端_2021-03-08.PDF

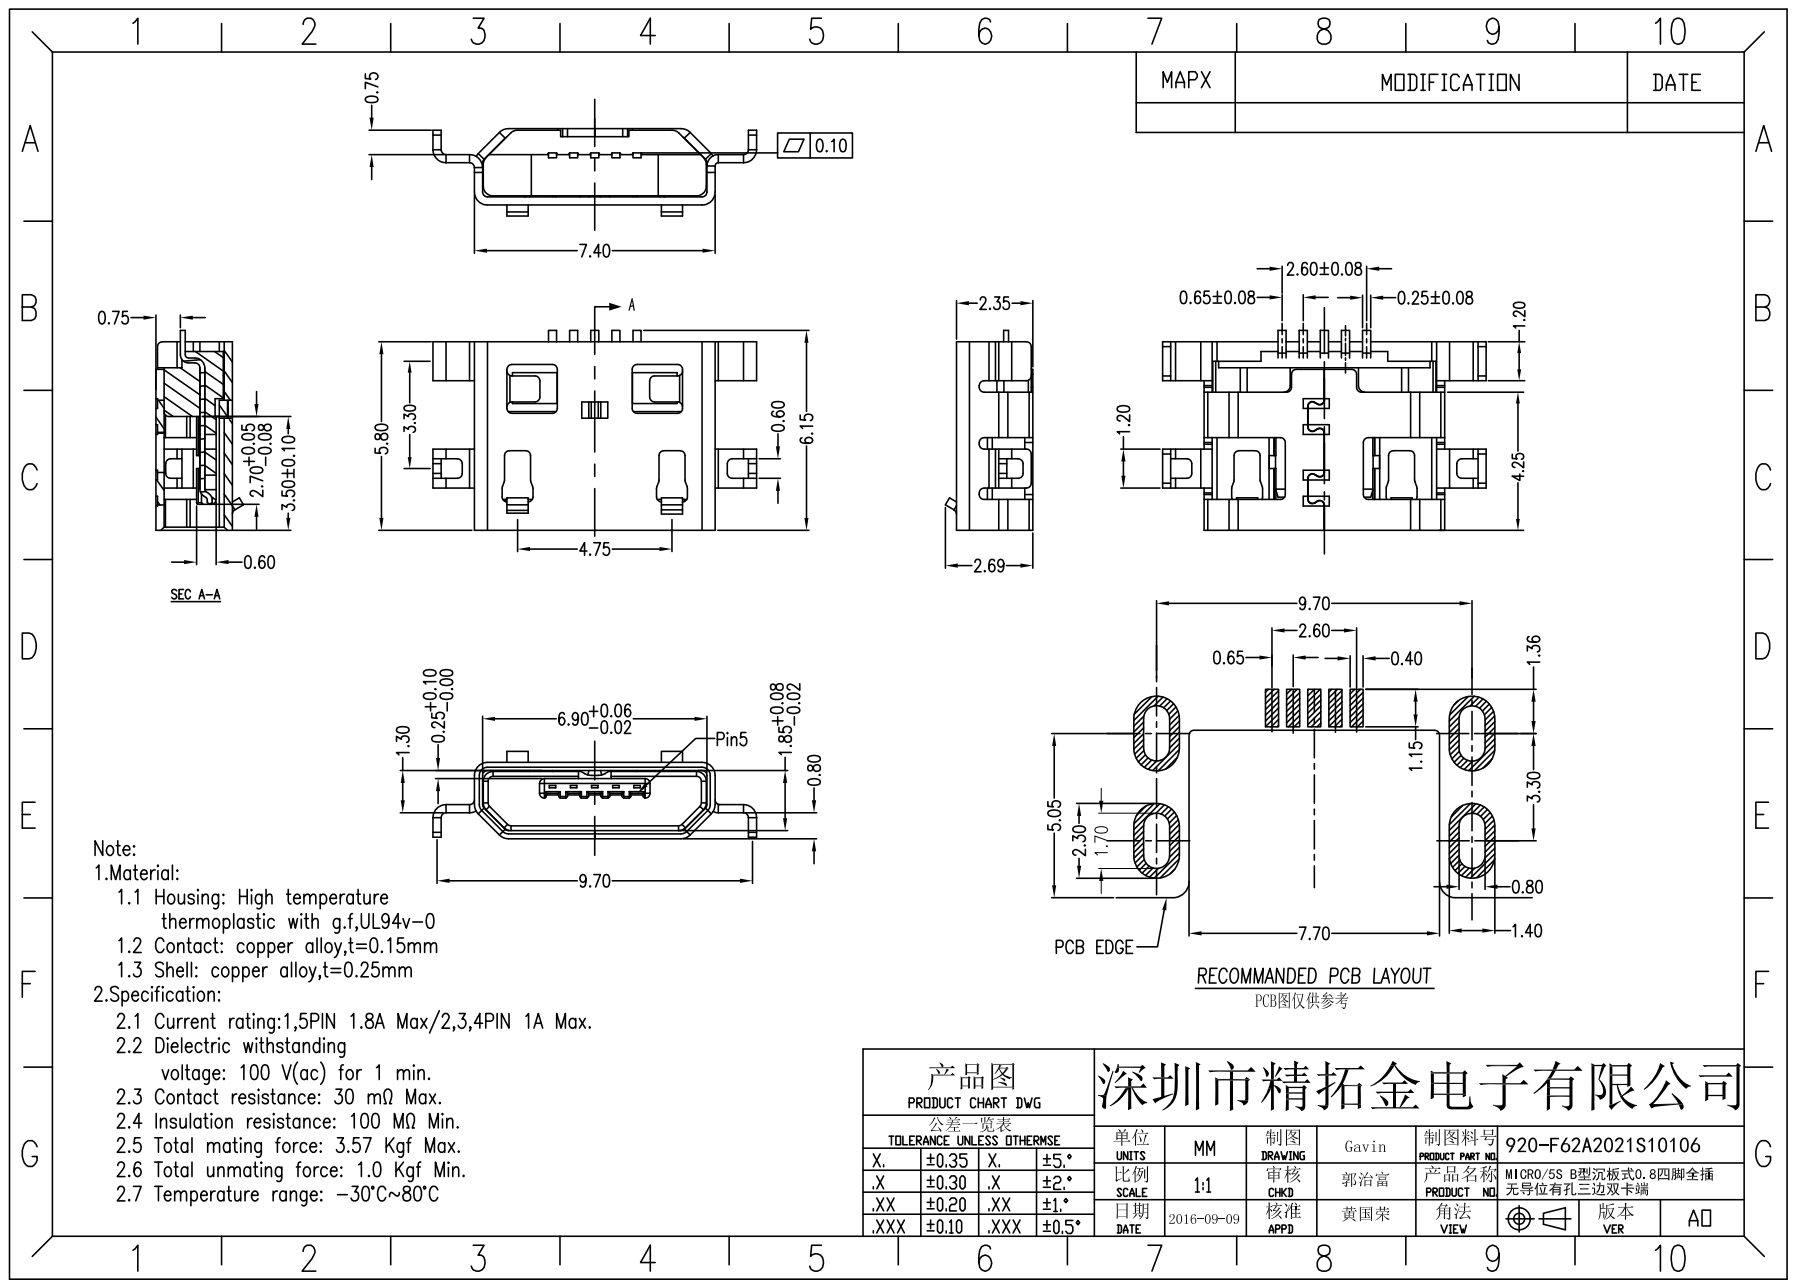
[picture p38: page 1]
