Xing-Zao/Shenfenpai-Guangyingtanceyi/Badge/Badge-A/02_Electronics/01_source/01_new_source/main_V1.0/main_V1.0.kicad_pcb

## KiCad design Badge/Badge-A/02_Electronics/01_source/01_new_source/main_V1.0/main_V1.0.kicad_pcb (2021-05-12)

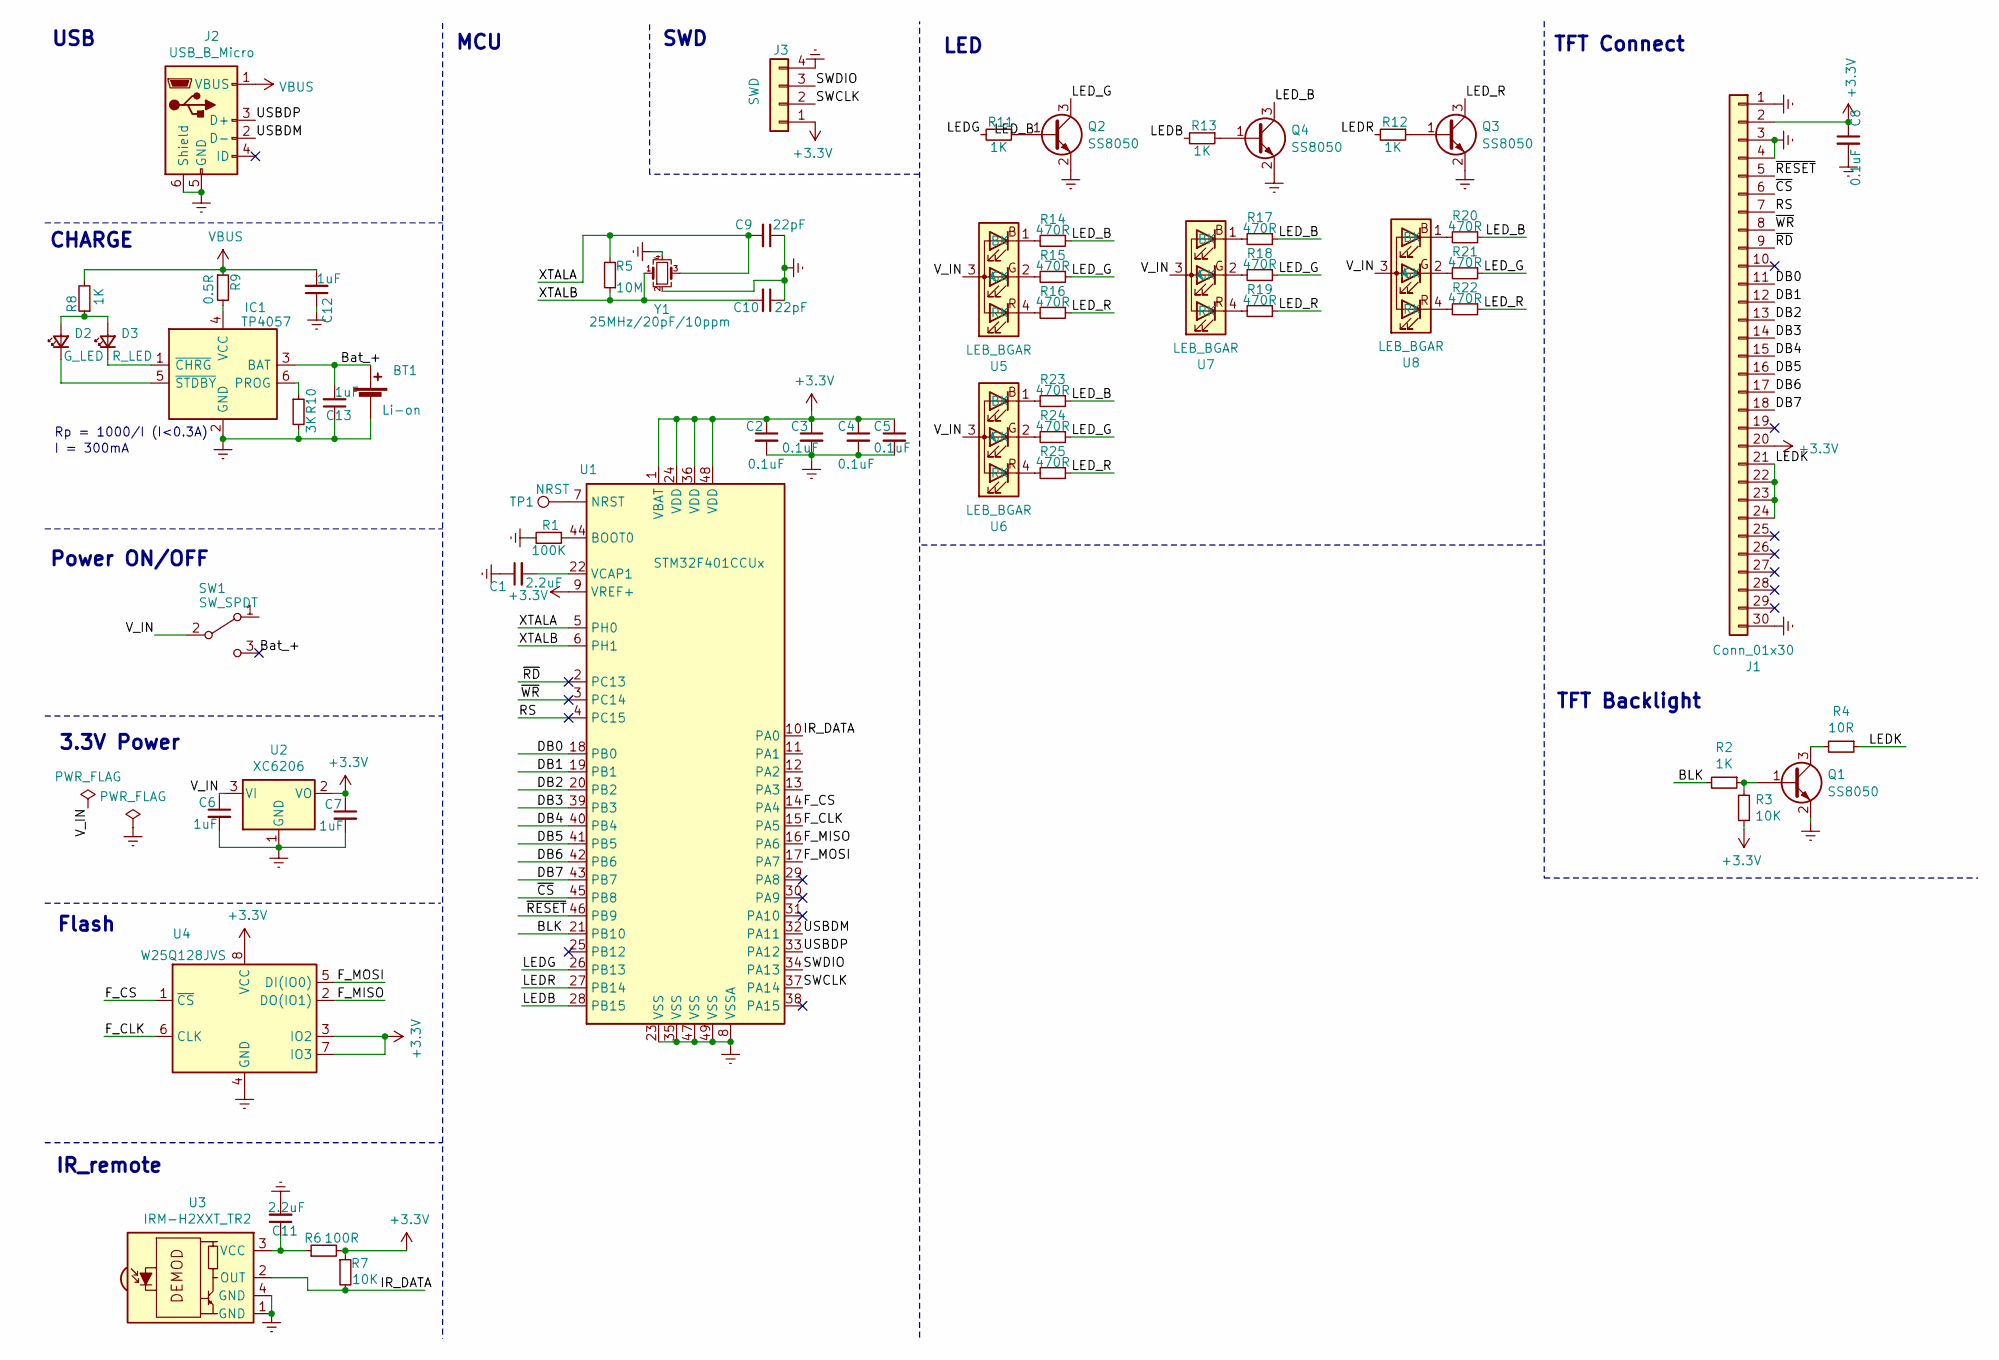
[picture p39: schematic main_V1.0.sch]

Parts:
BT1: Li-on; Pad-2.2mm_1.5x1.5
C1, C11: 2.2uF; C_0603_1608Metric
C2, C3, C4, C5, C8: 0.1uF; C_0402_1005Metric
C6, C7, C12, C13: 1uF; C_0603_1608Metric
C9, C10: 22pF; C_0603_1608Metric
D2: G_LED; LED_0603_1608Metric
D3: R_LED; LED_0603_1608Metric
IC1: TP4057; SOT-23-6; Manufacturer_Part_Number TP4057-42-SOT26-R
J1: Conn_01x30; FFC-1x30-1MP_P0.5mm_Horizontal
J2: USB_B_Micro; USB_Micro-B_Molex_Sink
J3: SWD; Con-1x4-P1.25mm
Q1, Q2, Q3, Q4: SS8050; SOT-23
R1: 100K; R_0603_1608Metric
R2, R8, R11, R12, R13: 1K; R_0402_1005Metric
R3, R7: 10K; R_0603_1608Metric
R4: 10R; R_0603_1608Metric
R5: 10M; R_0603_1608Metric
R6: 100R; R_0603_1608Metric
R9: 0.5R; R_0805_2012Metric
R10: 3K; R_0603_1608Metric
R14, R15, R16, R17, R18, R19, R20, R21, R22, R23, R24, R25: 470R; R_0402_1005Metric
SW1: SW_SPDT; MSKT-12C00-switch-smd
TP1: NRST; TestPoint_Pad_D1.0mm
U1: STM32F401CCUx; QFN-48-1EP_7x7mm_P0.5mm_EP5.6x5.6mm
U2: XC6206; SOT-23
U3: IRM-H2XXT_TR2
U4: W25Q128JVS; SON127P800X600X80-9N-D
U5, U6, U7, U8: LEB_BGAR; RGB-3510-Side-Common_anode
Y1: 25MHz/20pF/10ppm; Crystal_SMD_2520-4Pin_2.5x2.0mm

Connections:
+3V3: C2.1, C3.1, C4.1, C5.1, C7.1, C8.1, J1.2, J1.20, J3.1, R3.1, R6.2, R7.1, U1.1 (VBAT), U1.9 (VREF+), U1.24 (VDD), U1.36 (VDD), U1.48 (VDD), U2.2 (VO), U4.3 (IO2), U4.7 (IO3), U4.8 (VCC)
/BLK: R2.2, U1.21 (PB10)
/Bat_+: BT1.1 (+), C13.2, IC1.3 (BAT), SW1.3 (C)
/DB0: J1.11, U1.18 (PB0)
/DB1: J1.12, U1.19 (PB1)
/DB2: J1.13, U1.20 (PB2)
/DB3: J1.14, U1.39 (PB3)
/DB4: J1.15, U1.40 (PB4)
/DB5: J1.16, U1.41 (PB5)
/DB6: J1.17, U1.42 (PB6)
/DB7: J1.18, U1.43 (PB7)
/F_CLK: U1.15 (PA5), U4.6 (CLK)
/F_CS: U1.14 (PA4), U4.1 (~CS)
/F_MISO: U1.16 (PA6), U4.2 (DO(IO1))
/F_MOSI: U1.17 (PA7), U4.5 (DI(IO0))
/IR_DATA: R7.2, U1.10 (PA0), U3.2 (OUT)
/LEDB: R13.2, U1.28 (PB15)
/LEDG: R11.2, U1.26 (PB13)
/LEDK: J1.21, J1.22, J1.23, J1.24, R4.1
/LEDR: R12.2, U1.27 (PB14)
/LED_B: Q4.3 (C), R14.1, R17.1, R20.1, R23.1
/LED_G: Q2.3 (C), R15.1, R18.1, R21.1, R24.1
/LED_R: Q3.3 (C), R16.1, R19.1, R22.1, R25.1
/RS: J1.7, U1.4 (PC15)
/SWCLK: J3.2, U1.37 (PA14)
/SWDIO: J3.3, U1.34 (PA13)
/USBDM: J2.2 (D-), U1.32 (PA11)
/USBDP: J2.3 (D+), U1.33 (PA12)
/V_IN: C6.1, SW1.2 (B), U2.3 (VI), U5.3 (A), U6.3 (A), U7.3 (A), U8.3 (A)
/XTALA: C9.2, R5.2, U1.5 (PH0), Y1.3
/XTALB: C10.2, R5.1, U1.6 (PH1), Y1.1
/~CS: J1.6, U1.45 (PB8)
/~RD: J1.9, U1.2 (PC13)
/~RESET: J1.5, U1.46 (PB9)
/~WR: J1.8, U1.3 (PC14)
Earth: BT1.2 (-), C1.1, C2.2, C3.2, C4.2, C5.2, C6.2, C7.2, C8.2, C9.1, C10.1, C11.2, C12.1, C13.1, IC1.2 (GND), J1.1, J1.3, J1.4, J1.30, J2.5 (GND), J2.6 (Shield), J3.4, Q1.2 (E), Q2.2 (E), Q3.2 (E), Q4.2 (E), R1.2, R10.2, U1.8 (VSSA), U1.23 (VSS), U1.35 (VSS), U1.47 (VSS), U1.49 (VSS), U2.1 (GND), U3.1 (GND), U3.4 (GND), U4.4 (GND), Y1.2, Y1.4
unnamed: C1.2, U1.22 (VCAP1)
unnamed: C11.1, R6.1, U3.3 (VCC)
unnamed: D2.1 (K), IC1.5 (~STDBY)
unnamed: D2.2 (A), D3.2 (A), R8.1
unnamed: D3.1 (K), IC1.1 (~CHRG)
unnamed: IC1.4 (VCC), R9.2
unnamed: IC1.6 (PROG), R10.1
unnamed: Q1.1 (B), R2.1, R3.2
unnamed: Q1.3 (C), R4.2
unnamed: Q2.1 (B), R11.1
unnamed: Q3.1 (B), R12.1
unnamed: Q4.1 (B), R13.1
unnamed: R1.1, U1.44 (BOOT0)
unnamed: R14.2, U5.1 (BK)
unnamed: R15.2, U5.2 (GK)
unnamed: R16.2, U5.4 (RK)
unnamed: R17.2, U7.1 (BK)
unnamed: R18.2, U7.2 (GK)
unnamed: R19.2, U7.4 (RK)
unnamed: R20.2, U8.1 (BK)
unnamed: R21.2, U8.2 (GK)
unnamed: R22.2, U8.4 (RK)
unnamed: R23.2, U6.1 (BK)
unnamed: R24.2, U6.2 (GK)
unnamed: R25.2, U6.4 (RK)
unnamed: TP1.1, U1.7 (NRST)
VBUS: C12.2, J2.1 (VBUS), R8.2, R9.1

Notes on the sheet:
3.3V Power
Power ON/OFF
TFT Backlight
LED
TFT Connect
MCU
SWD
Rp = 1000/I (I<0.3A)
I = 300mA
USB
CHARGE
Flash
IR_remote

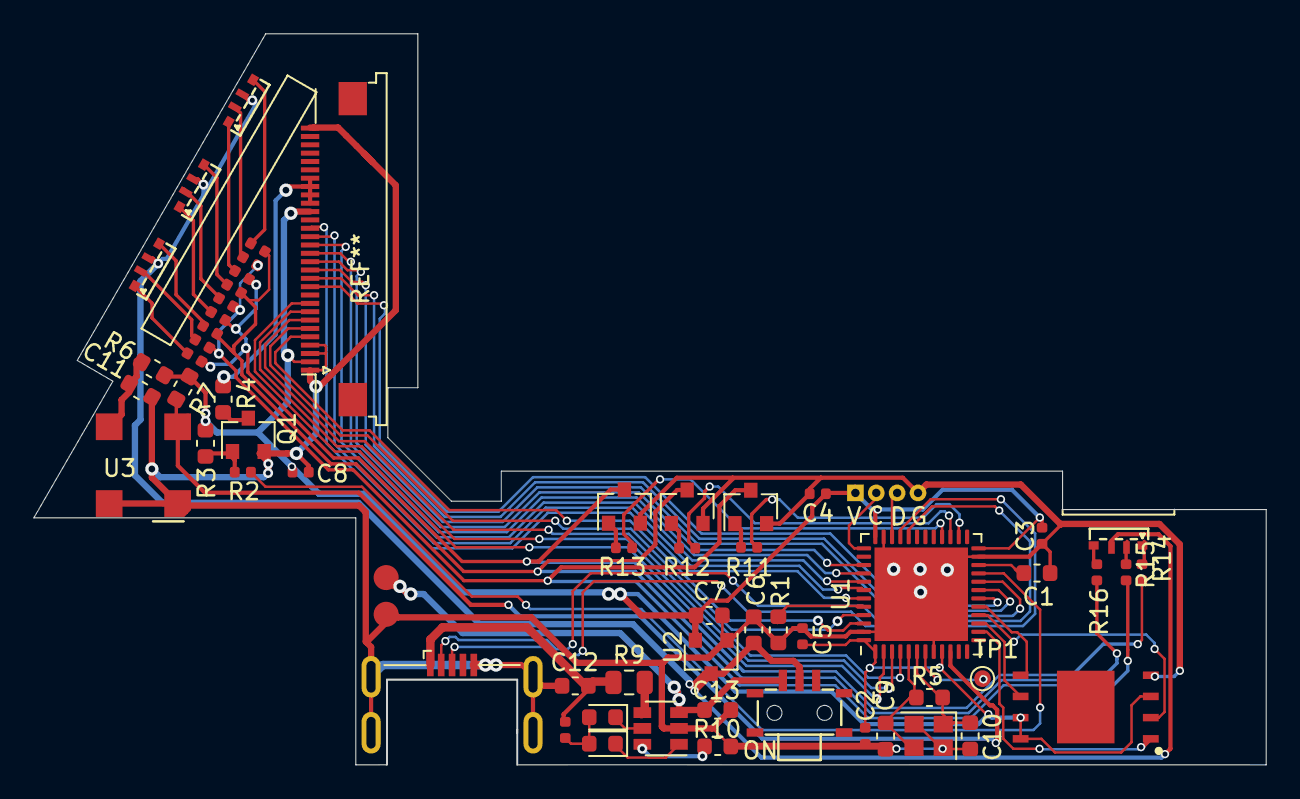
[picture p40: board main_V1.0.kicad_pcb from above]

Board: 2 copper layers, 73.8 x 43.8 mm, 60 parts (0 on the bottom side), 63 nets.
