Xing-Zao/Shenfenpai-Guangyingtanceyi/Light_detector/02_Electronics/01_source/01_new_source/main_V1.1/Light_detector_V1.0.kicad_pcb

## KiCad design Light_detector/02_Electronics/01_source/01_new_source/main_V1.1/Light_detector_V1.0.kicad_pcb (2021-05-12)

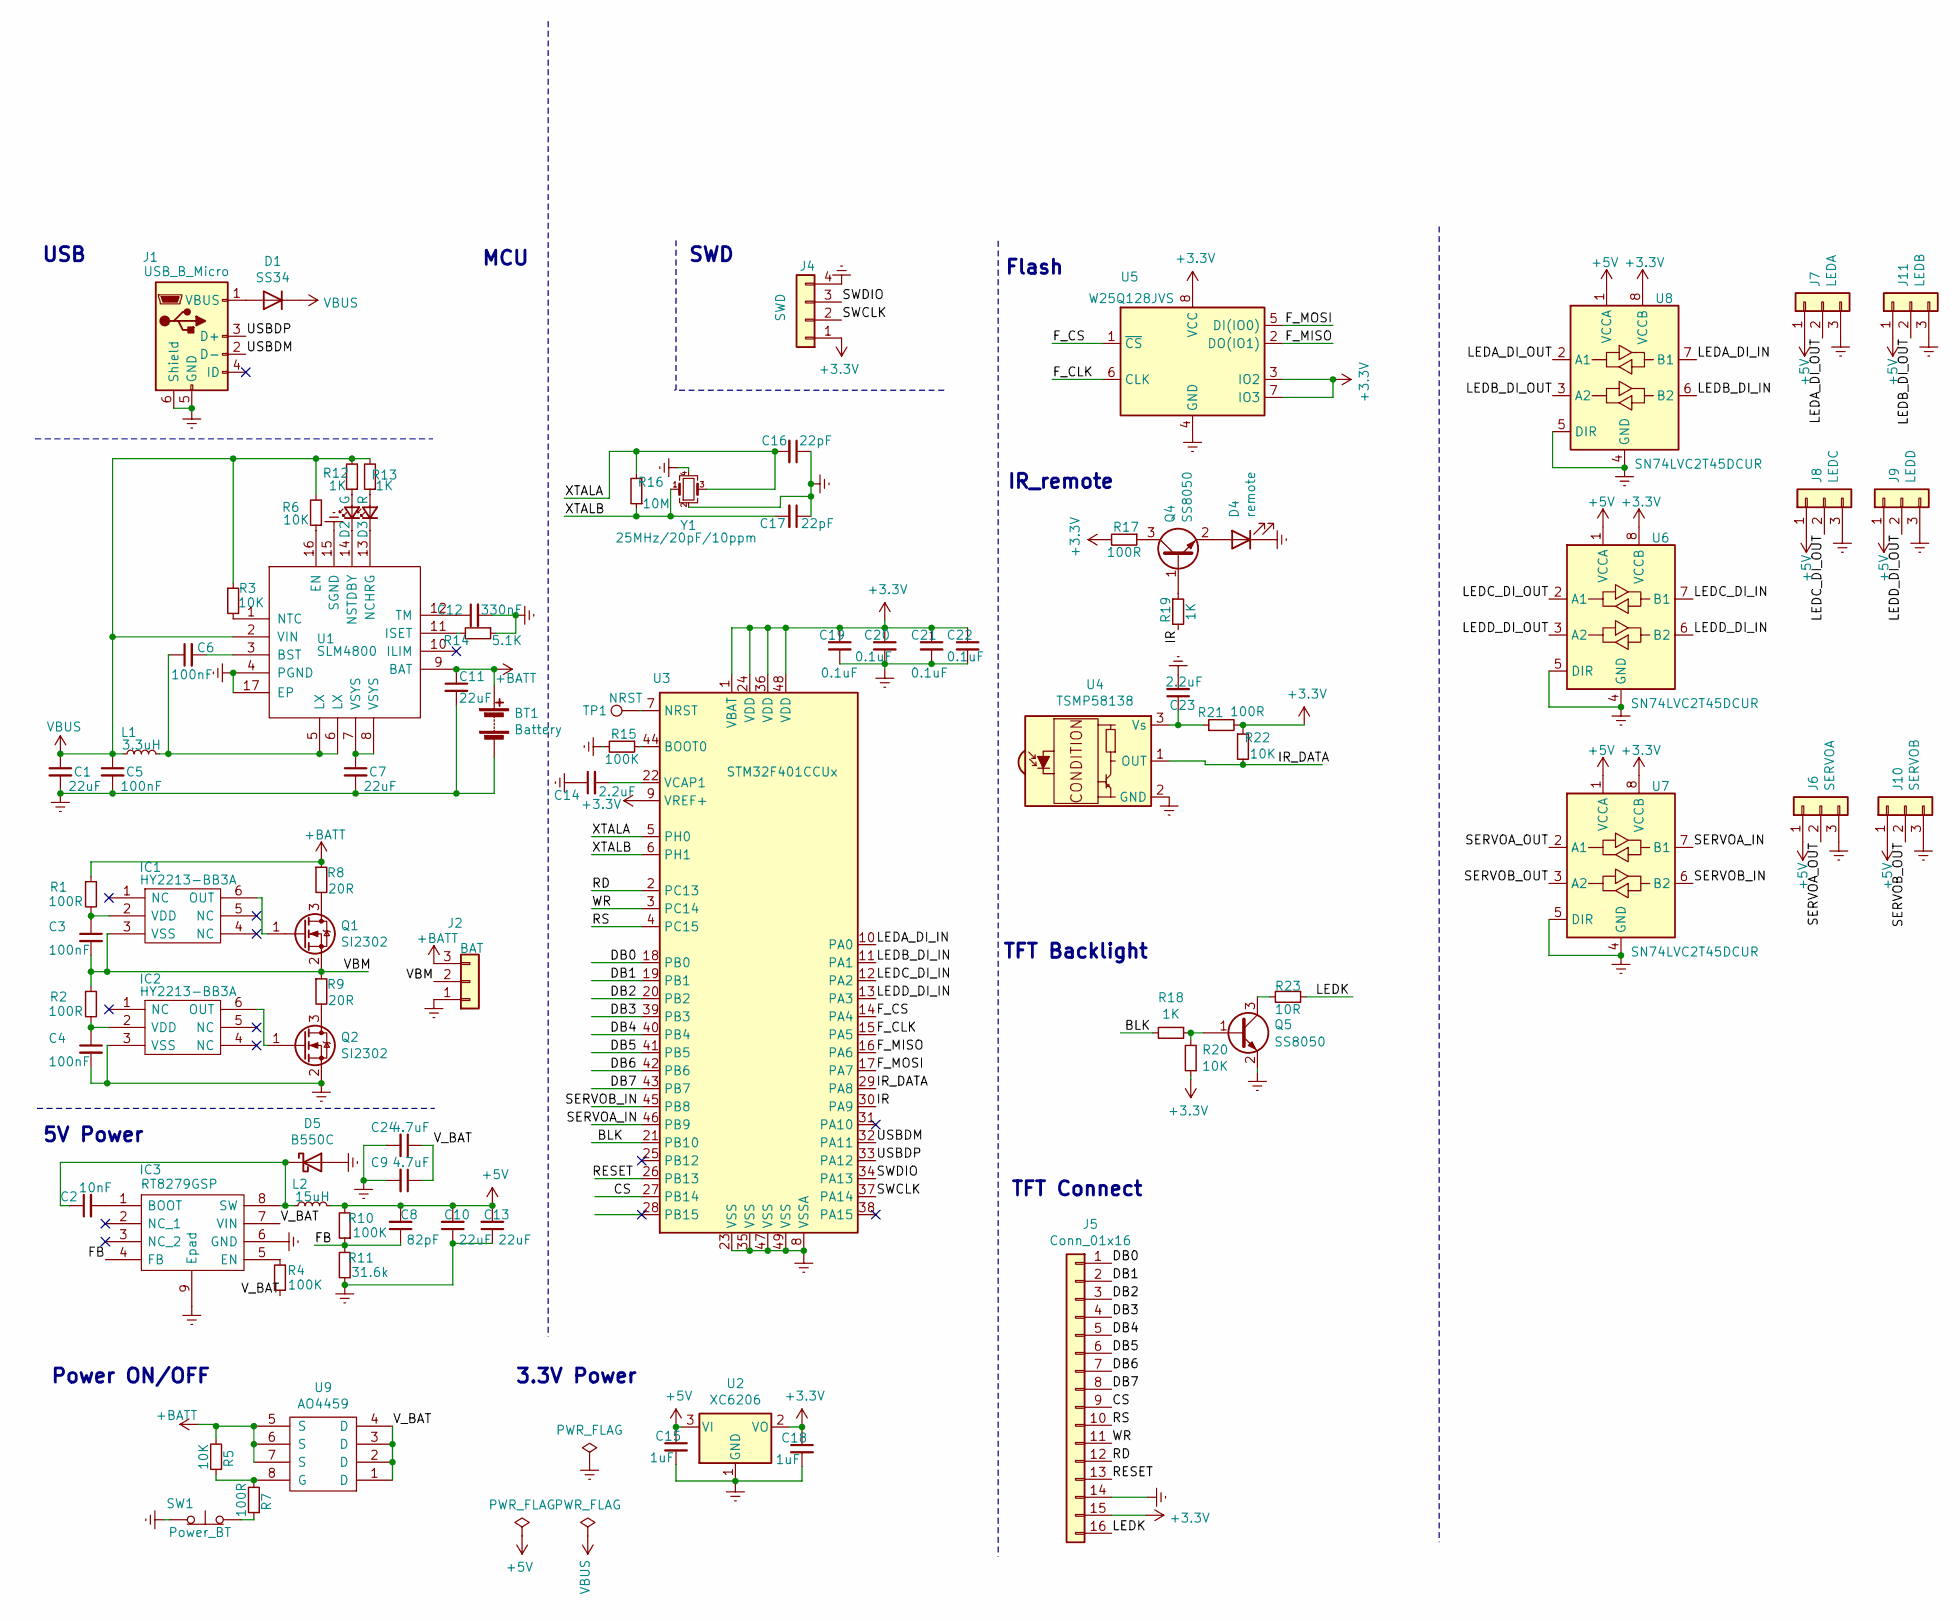
[picture p41: schematic Light_detector_V1.0.sch]

Parts:
BT1: Battery; JWT_A3963_1x02_P3.96mm_Vertical
C1, C7, C10, C11, C13: 22uF; C_1206_3216Metric
C2: 10nF; C_0402_1005Metric
C3, C4, C5, C6: 100nF; C_0402_1005Metric
C8: 82pF; C_0402_1005Metric
C9, C24: 4.7uF; C_1206_3216Metric
C12: 330nF; C_0402_1005Metric
C14, C23: 2.2uF; C_0603_1608Metric
C15, C18: 1uF; C_0603_1608Metric
C16, C17: 22pF; C_0402_1005Metric
C19, C20, C21, C22: 0.1uF; C_0402_1005Metric
D1: SS34; D_SMA
D2: G; LED_0603_1608Metric
D3: R; LED_0603_1608Metric
D4: remote; Con-2.5mm_0.9x1.7
D5: B550C; D_SMC
IC1, IC2: HY2213-BB3A; SOT95P280X140-6N; Manufacturer_Part_Number HY2213-BB3A
IC3: RT8279GSP; Diodes_SO-8EP; Manufacturer_Part_Number RT8279GSP
J1: USB_B_Micro; USB_Micro-B_Molex-105017-0001
J2: BAT; JST_XH_S3B-XH-A-1_1x03_P2.50mm_Horizontal
J4: SWD; PinHeader_1x04_P1.27mm_Vertical
J5: Conn_01x16; TE_1-1734839-6_1x16-1MP_P0.5mm_Horizontal
J6: SERVOA; PinHeader_1x03_P2.54mm_Horizontal
J7: LEDA; JST_XH_S3B-XH-A-1_1x03_P2.50mm_Horizontal
J8: LEDC; JST_XH_S3B-XH-A-1_1x03_P2.50mm_Horizontal
J9: LEDD; JST_XH_S3B-XH-A-1_1x03_P2.50mm_Horizontal
J10: SERVOB; PinHeader_1x03_P2.54mm_Horizontal
J11: LEDB; JST_XH_S3B-XH-A-1_1x03_P2.50mm_Horizontal
L1: 3.3uH; L_Sumida_CDMC6D28_7.25x6.5mm
L2: 15uH; L_Neosid_SM-PIC1004H
Q1, Q2: SI2302; SOT-23
Q4, Q5: SS8050; SOT-23
R1, R2, R7: 100R; R_0402_1005Metric
R3, R5, R6, R20, R22: 10K; R_0402_1005Metric
R4, R10, R15: 100K; R_0402_1005Metric
R8, R9: 20R; R_2512_6332Metric
R11: 31.6k; R_0402_1005Metric
R12, R13, R18, R19: 1K; R_0402_1005Metric
R14: 5.1K; R_0402_1005Metric
R16: 10M; R_0402_1005Metric
R17, R21: 100R; R_0603_1608Metric
R23: 10R; R_0603_1608Metric
SW1: Power_BT; JST_XH_S2B-XH-A-1_1x02_P2.50mm_Horizontal
TP1: NRST; TestPoint_Pad_D1.0mm
U1: SLM4800; QFN-16-1EP_4x4mm_P0.65mm_EP2.1x2.1mm_ThermalVias
U2: XC6206; SOT-23
U3: STM32F401CCUx; QFN-48-1EP_7x7mm_P0.5mm_EP5.6x5.6mm
U4: TSMP58138; Vishay_MINICAST-3Pin
U5: W25Q128JVS; SON127P800X600X80-9N-D
U6, U7, U8: SN74LVC2T45DCUR; VSSOP-8_2.4x2.1mm_P0.5mm
U9: AO4459; SOP-8_3.9x4.9mm_P1.27mm
Y1: 25MHz/20pF/10ppm; Crystal_SMD_2520-4Pin_2.5x2.0mm

Connections:
+3V3: C18.1, C19.1, C20.1, C21.1, C22.1, J4.1, J5.15, R17.2, R20.1, R21.2, R22.1, U2.2 (VO), U3.1 (VBAT), U3.9 (VREF+), U3.24 (VDD), U3.36 (VDD), U3.48 (VDD), U5.3 (IO2), U5.7 (IO3), U5.8 (VCC), U6.8 (VCCB), U7.8 (VCCB), U8.8 (VCCB)
+5V: C8.2, C10.2, C13.2, C15.1, J6.1, J7.1, J8.1, J9.1, J10.1, J11.1, L2.2, R10.2, U2.3 (VI), U6.1 (VCCA), U7.1 (VCCA), U8.1 (VCCA)
+BATT: BT1.1 (+), C11.1, J2.3, R1.1, R5.2, R8.1, U1.9 (BAT), U9.5 (S), U9.6 (S), U9.7 (S)
/BLK: R18.2, U3.21 (PB10)
/CS: J5.9, U3.27 (PB14)
/DB0: J5.1, U3.18 (PB0)
/DB1: J5.2, U3.19 (PB1)
/DB2: J5.3, U3.20 (PB2)
/DB3: J5.4, U3.39 (PB3)
/DB4: J5.5, U3.40 (PB4)
/DB5: J5.6, U3.41 (PB5)
/DB6: J5.7, U3.42 (PB6)
/DB7: J5.8, U3.43 (PB7)
/FB: C8.1, IC3.4 (FB), R10.1, R11.2
/F_CLK: U3.15 (PA5), U5.6 (CLK)
/F_CS: U3.14 (PA4), U5.1 (~CS)
/F_MISO: U3.16 (PA6), U5.2 (DO(IO1))
/F_MOSI: U3.17 (PA7), U5.5 (DI(IO0))
/IR: R19.2, U3.30 (PA9)
/IR_DATA: R22.2, U3.29 (PA8), U4.1 (OUT)
/LEDA_DI_IN: U3.10 (PA0), U8.7 (B1)
/LEDA_DI_OUT: J7.2, U8.2 (A1)
/LEDB_DI_IN: U3.11 (PA1), U8.6 (B2)
/LEDB_DI_OUT: J11.2, U8.3 (A2)
/LEDC_DI_IN: U3.12 (PA2), U6.7 (B1)
/LEDC_DI_OUT: J8.2, U6.2 (A1)
/LEDD_DI_IN: U3.13 (PA3), U6.6 (B2)
/LEDD_DI_OUT: J9.2, U6.3 (A2)
/LEDK: J5.16, R23.1
/RD: J5.12, U3.2 (PC13)
/RESET: J5.13, U3.26 (PB13)
/RS: J5.10, U3.4 (PC15)
/SERVOA_IN: U3.46 (PB9), U7.7 (B1)
/SERVOA_OUT: J6.2, U7.2 (A1)
/SERVOB_IN: U3.45 (PB8), U7.6 (B2)
/SERVOB_OUT: J10.2, U7.3 (A2)
/SWCLK: J4.2, U3.37 (PA14)
/SWDIO: J4.3, U3.34 (PA13)
/USBDM: J1.2 (D-), U3.32 (PA11)
/USBDP: J1.3 (D+), U3.33 (PA12)
/VBM: C3.2, IC1.3 (VSS), J2.2, Q1.2 (S), R2.1, R9.1
/V_BAT: C9.1, C24.1, IC3.7 (VIN), R4.1, U9.1 (D), U9.2 (D), U9.3 (D), U9.4 (D)
/WR: J5.11, U3.3 (PC14)
/XTALA: C16.2, R16.2, U3.5 (PH0), Y1.3
/XTALB: C17.2, R16.1, U3.6 (PH1), Y1.1
Earth: BT1.2 (-), C1.2, C4.2, C5.2, C7.2, C9.2, C10.1, C11.2, C12.2, C13.1, C14.1, C15.2, C16.1, C17.1, C18.2, C19.2, C20.2, C21.2, C22.2, C23.2, C24.2, D4.1 (K), D5.2 (A), IC2.3 (VSS), IC3.6 (GND), IC3.9 (Epad), J1.5 (GND), J1.6 (Shield), J2.1, J4.4, J5.14, J6.3, J7.3, J8.3, J9.3, J10.3, J11.3, Q2.2 (S), Q5.2 (E), R11.1, R14.1, R15.2, SW1.1 (A), U1.4 (PGND), U1.15 (SGND), U1.17 (EP), U2.1 (GND), U3.8 (VSSA), U3.23 (VSS), U3.35 (VSS), U3.47 (VSS), U3.49 (VSS), U4.2 (GND), U5.4 (GND), U6.4 (GND), U6.5 (DIR), U7.4 (GND), U7.5 (DIR), U8.4 (GND), U8.5 (DIR), Y1.2, Y1.4
unnamed: C2.1, D5.1 (K), IC3.8 (SW), L2.1
unnamed: C2.2, IC3.1 (BOOT)
unnamed: C3.1, IC1.2 (VDD), R1.2
unnamed: C4.1, IC2.2 (VDD), R2.2
unnamed: C6.1, L1.2, U1.5 (LX), U1.6 (LX)
unnamed: C6.2, U1.3 (BST)
unnamed: C7.1, U1.7 (VSYS), U1.8 (VSYS)
unnamed: C12.1, U1.12 (TM)
unnamed: C14.2, U3.22 (VCAP1)
unnamed: C23.1, R21.1, U4.3 (Vs)
unnamed: D1.2 (A), J1.1 (VBUS)
unnamed: D2.1 (K), U1.14 (NSTDBY)
unnamed: D2.2 (A), R12.1
unnamed: D3.1 (K), U1.13 (NCHRG)
unnamed: D3.2 (A), R13.1
unnamed: D4.2 (A), Q4.2 (E)
unnamed: IC1.6 (OUT), Q1.1 (G)
unnamed: IC2.6 (OUT), Q2.1 (G)
unnamed: IC3.5 (EN), R4.2
unnamed: Q1.3 (D), R8.2
unnamed: Q2.3 (D), R9.2
unnamed: Q4.1 (B), R19.1
unnamed: Q4.3 (C), R17.1
unnamed: Q5.1 (B), R18.1, R20.2
unnamed: Q5.3 (C), R23.2
unnamed: R3.2, U1.1 (NTC)
unnamed: R5.1, R7.2, U9.8 (G)
unnamed: R6.1, U1.16 (EN)
unnamed: R7.1, SW1.2 (B)
unnamed: R14.2, U1.11 (ISET)
unnamed: R15.1, U3.44 (BOOT0)
unnamed: TP1.1, U3.7 (NRST)
VBUS: C1.1, C5.1, D1.1 (K), L1.1, R3.1, R6.2, R12.2, R13.2, U1.2 (VIN)

Notes on the sheet:
3.3V Power
Power ON/OFF
TFT Connect
MCU
SWD
USB
Flash
5V Power
TFT Backlight
IR_remote

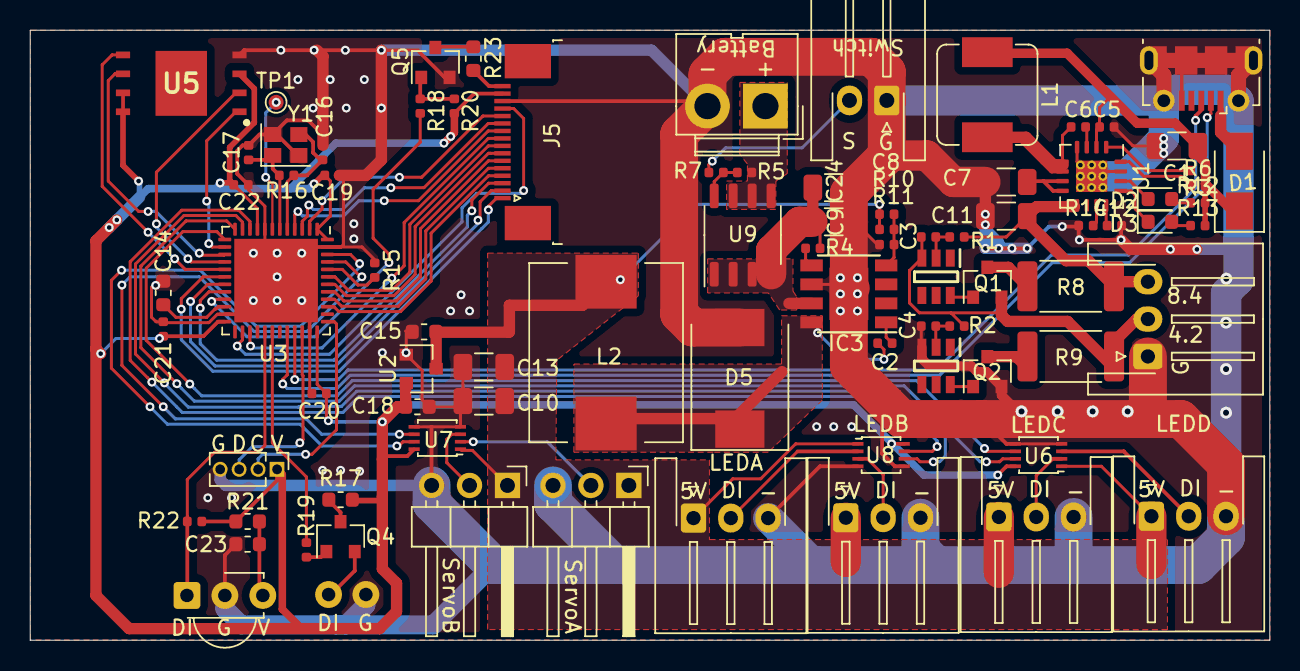
[picture p42: board Light_detector_V1.0.kicad_pcb from above]

Board: 2 copper layers, 83.0 x 40.9 mm, 84 parts (0 on the bottom side), 79 nets.
